Janik313/Pflanzenwagen/40_Realisieren/Konzeptskizze.jpg

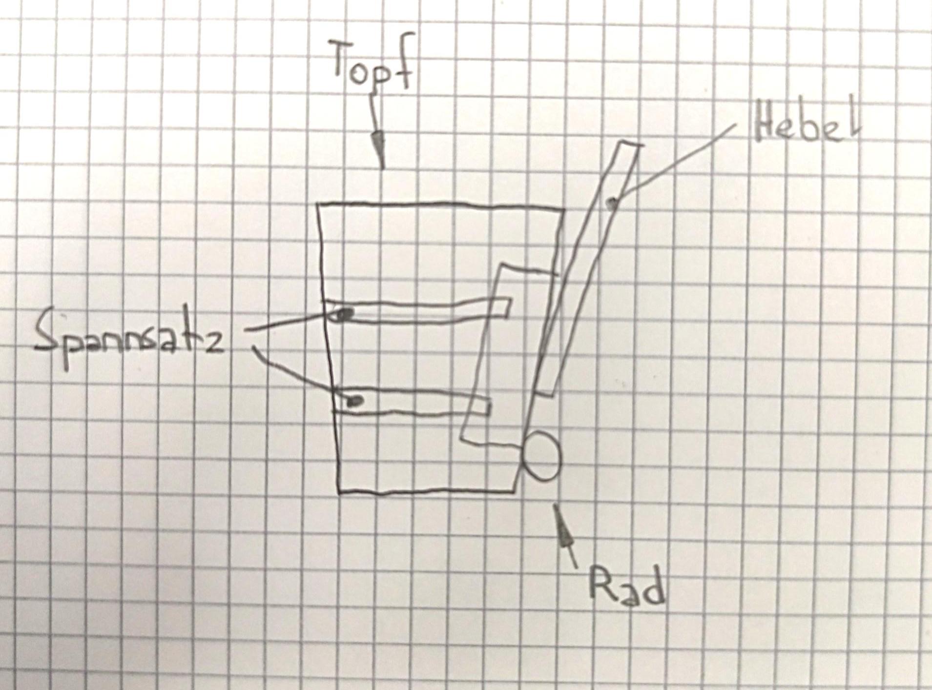
40_Realisieren/Konzeptskizze.jpg
