Janik313/Pflanzenwagen/20_Planen/Varianten/Variante3.png

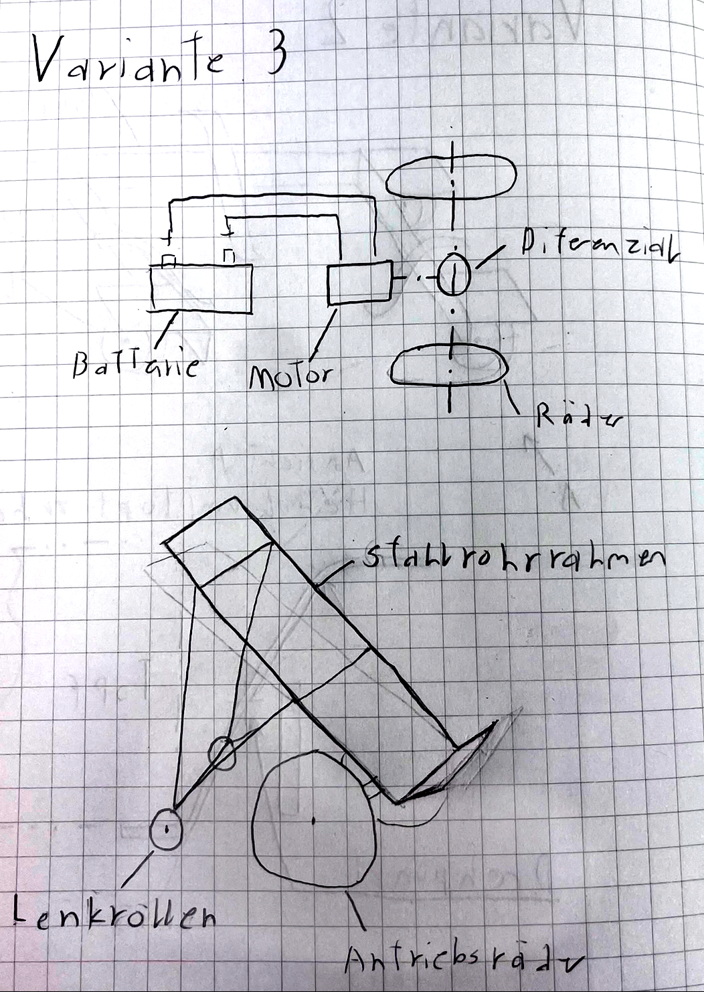
20_Planen/Varianten/Variante3.png
