Janik313/Pflanzenwagen/40_Realisieren/20_Inventor/20_Einkaufteile/Links zu teile.txt

Wheel
https://www.bauhaus.info/ersatzraeder/altrad-sackkarren-ersatzrad/p/25456800#anchor-product-services

Ratchet Strap
https://www.galaxus.ch/de/s4/product/spanset-zurrgurte-spanngurt-ladungssicherung-6051863

Roh Material Roh
https://shop.d-a.ch/de/Konstruktionsrohre-Stahl-S235JR-geschweisst-rohschwarz/p/M100610
(21/2" 76.1 3.6 6) für Hebel

https://shop.d-a.ch/de/Konstruktionsrohre-Stahl-S235JR-geschweisst-rohschwarz/p/M100610
(11/2" 48.3 3.20) für Griff

Mutter achse
BN 161 1118811 Sicherungsmutter M20

Round slider 42x2,5-5
https://www.emico.com/en-DE/emico/protective-products/pipe-inserts-lamellar-plugs/round-sliders-42x25-5-0850425
