Janik313/Pflanzenwagen/10_Informieren/Pflichtenheft.docx

Projektname:Pflanzenwagen Bearbeiter: Janik Wyder & Raoul Messerli
Anforderungen / Einflussgrössen | | F / W(G)

Bildschirmausschnitt

Funktions- und Leistungsanforderungen | - Pflanzentopf soll ohne merklichen Aufwand mit der Einrichtung aufgenommen werden können - Vorrichtung funktioniert auf unebenem Boden (Schotter) - Tragkraft bis 250kg | F F F

Bildschirmausschnitt

Qualitätsmerkmale | - Suva-Richtlinien beachten - Alle Einzelteilzeichnungen im CAD erstellt und vorhanden - Ein 3D CAD-Modell der Baugruppe muss vorhanden sein - Lange Lebensdauer | F F F W(4)

Bildschirmausschnitt

Marktanforderungen | - Einfache Bedienung durch eine Person | F

Bildschirmausschnitt

Fertigungskriterien | - Seriegrösse: 100 Stück - Einfache Herstellung möglich | F W(3)
Umweltaspekte | - Rezyklierbares Material | W(3)

Bildschirmausschnitt

Kosten | - Marktpreis zwischen 200.- und 400.- - Möglichst niedrige Kosten | F W(2)

Bildschirmausschnitt

Termine | Abgabe Projekt: 07.02.2023

Freigabe Auftraggeber:

Datum, Name: _________________________ Unterschrift: _________________________

F = Forderung (Vorgaben, die zwingend zu erfüllen sind)

W = Wunsch, (G) = Gewichtung Wunsch → 1 = schwacher Wunsch, 5 = starker Wunsch

\\intern.ch.rondodoge.com\users\Homes\Lang_a\Documents\Meine Datenquellen\1_RONDO\Projekte\Pflichtenheft Übung Taschenmesser.docx 09.01.2023 / LaA 5 / 6
