Janik313/Pflanzenwagen/40_Realisieren/20_Inventor/50_Berechung/Beruchungen.docx

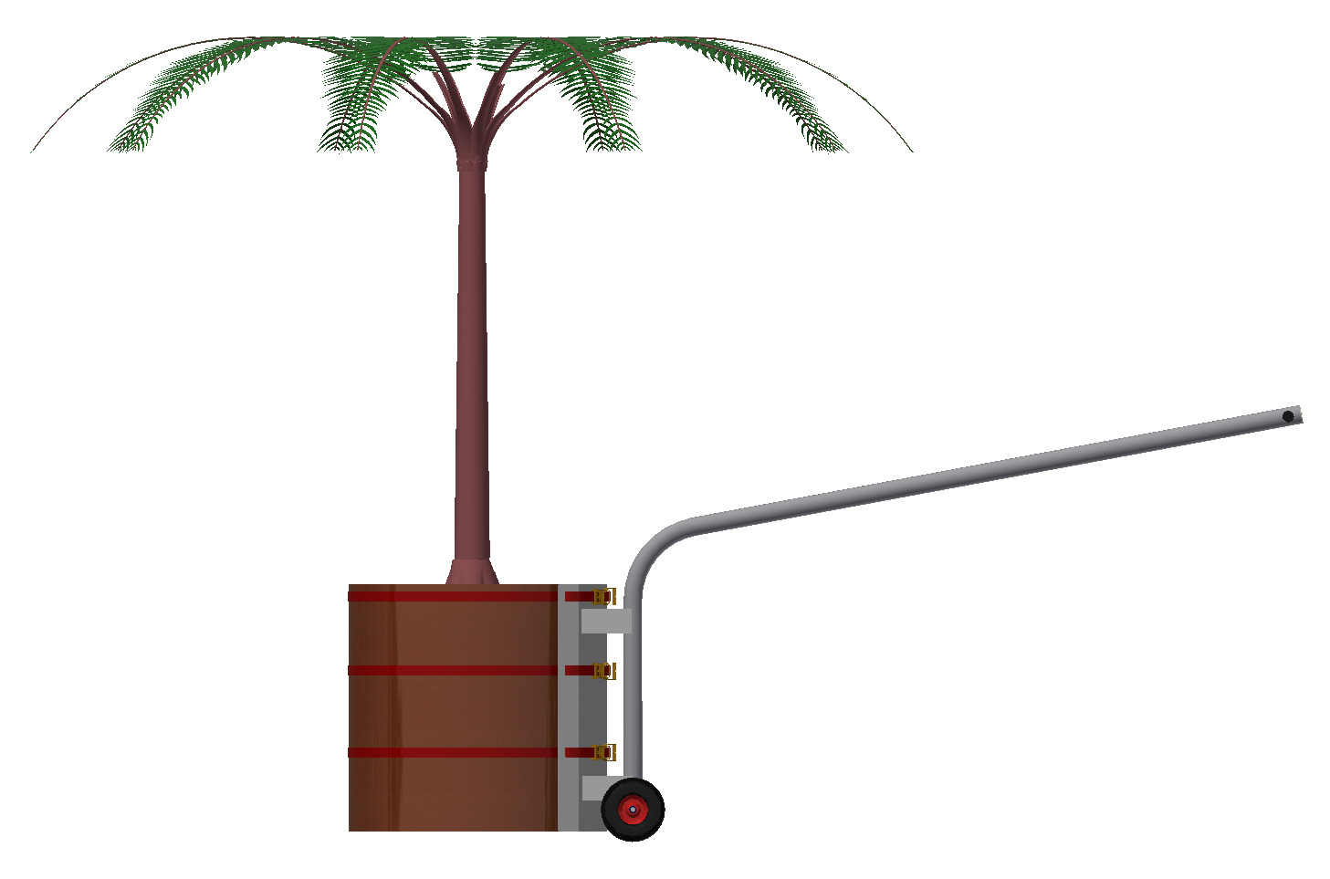
[picture p43: figure]

Hebel Länge:

Ftopf: 250 Kg

ltopf: 650mm

Fhebel: 400 N

g ≈ 10 m/s²

Gesucht lhebel

l_(hebel) =(F_(topf) ×l_(topf))/(F_(hebel))=(2500N×500mm)/(400N)=3125mm
