Janik313/Pflanzenwagen/00_Dokumentation/90_Vorlagen_Rondo/Anhang_Doku/2022 Projekte Workshop.docx

# 1 Vorrichtung für das Nachbearbeiten der geschweissten Walzen

Bevor die geschweissten Walzen auf der Mazak bearbeitet werden können, müssen Schweissspritzer und stark überstehende Schweissnähte weggeschliffen oder weggefeilt werden.

Es ist eine geeignete Vorrichtung zu entwickeln, wo die Walzen nur draufgelegt werden können und dann mithilfe eines Drehantriebes langsam rotieren. Dies würde das Nacharbeiten der Schweissnähte und Schweissspritzer sehr erleichtern.

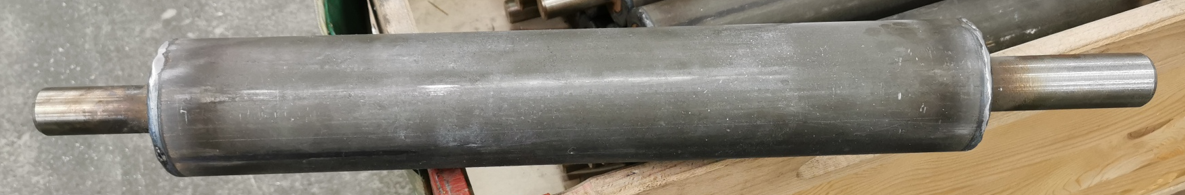
[picture p44: figure]
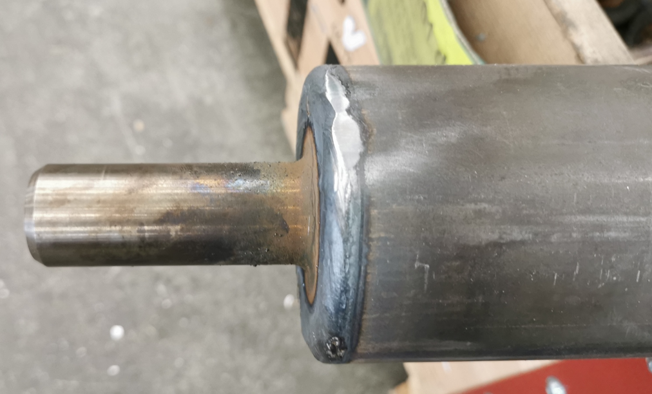
[picture p45: figure]

Entfernte Spritzer Schweissnaht geschliffen

Zu klären:

- Welche Walzen (Ø86, Ø100) ev. auch Walzen RONDO Schio (Ø150)?
- Welche Walzenlängen ev. auch Walzen RONDO Schio?
- Drehgeschwindigkeit? Soll diese regelbar sein?
- Steuerung, wo wer und wie?
- Wo soll die Vorrichtung aufgebaut sein (Wagen, Tisch, etc…)

Auftraggeber / Ansprechpartner

VF (Hansruedi Leuenberger) / WZ (Andreas Aebersold)

g:\berufsbildung\02 berufsbildungs-kommission\08_workshop\workshop 2022 - eriz\projekte\2022 projekte workshop .docx 31.03.202214 / 14

Workshop 2022 Projekte

Titel eingeben
