Janik313/Pflanzenwagen/00_Dokumentation/90_Vorlagen_Rondo/Pflichtenheft_2_unterschrieben.pdf

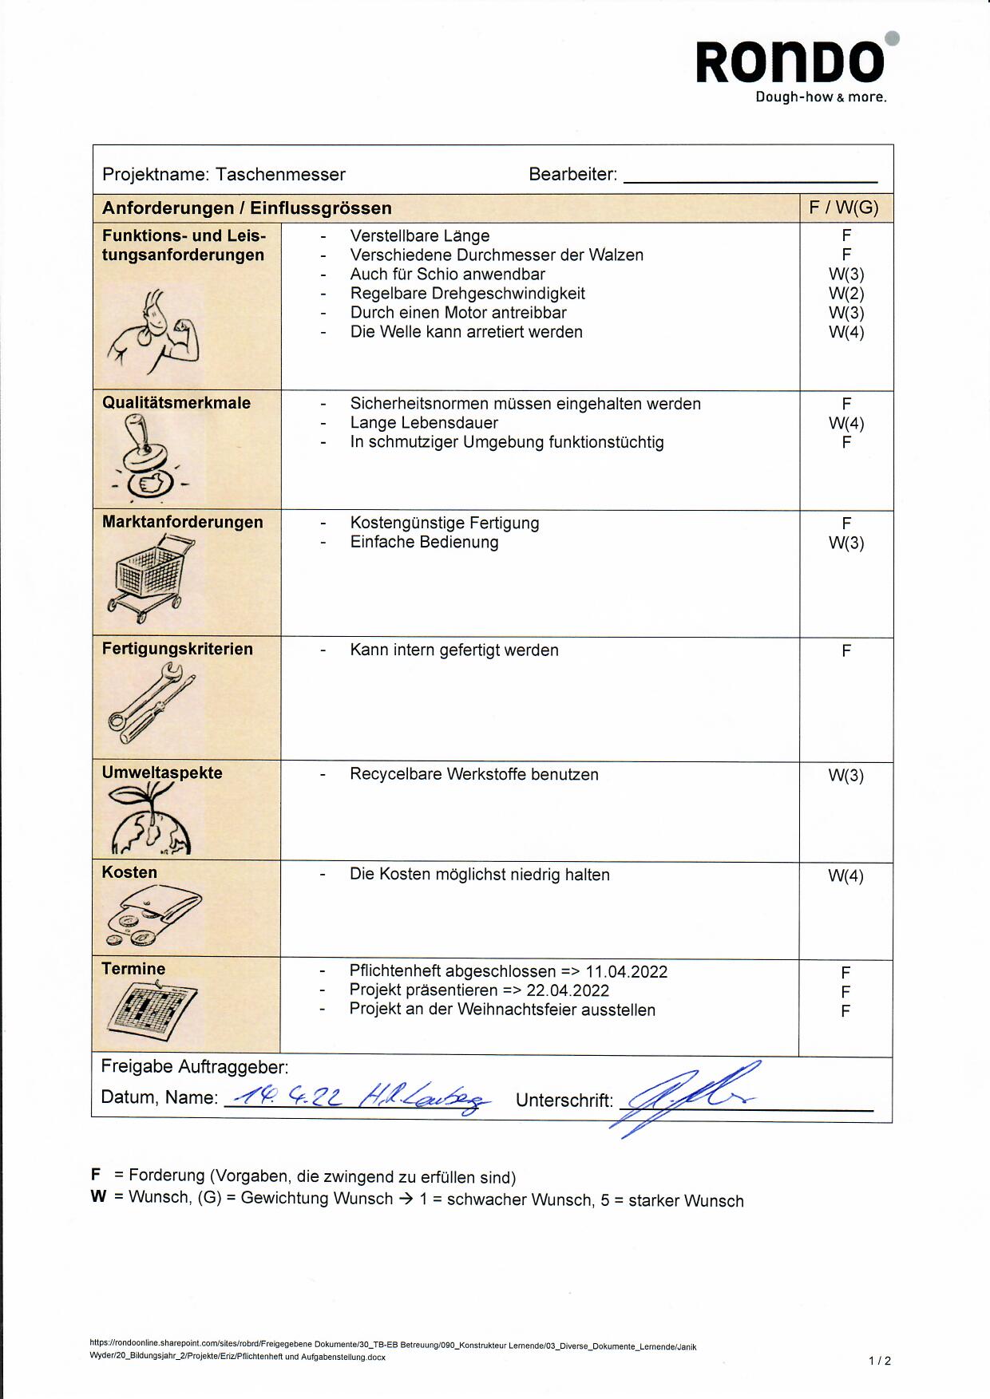
[picture p46: page 1]
