Janik313/Pflanzenwagen/20_Planen/Varianten/Variante1.png

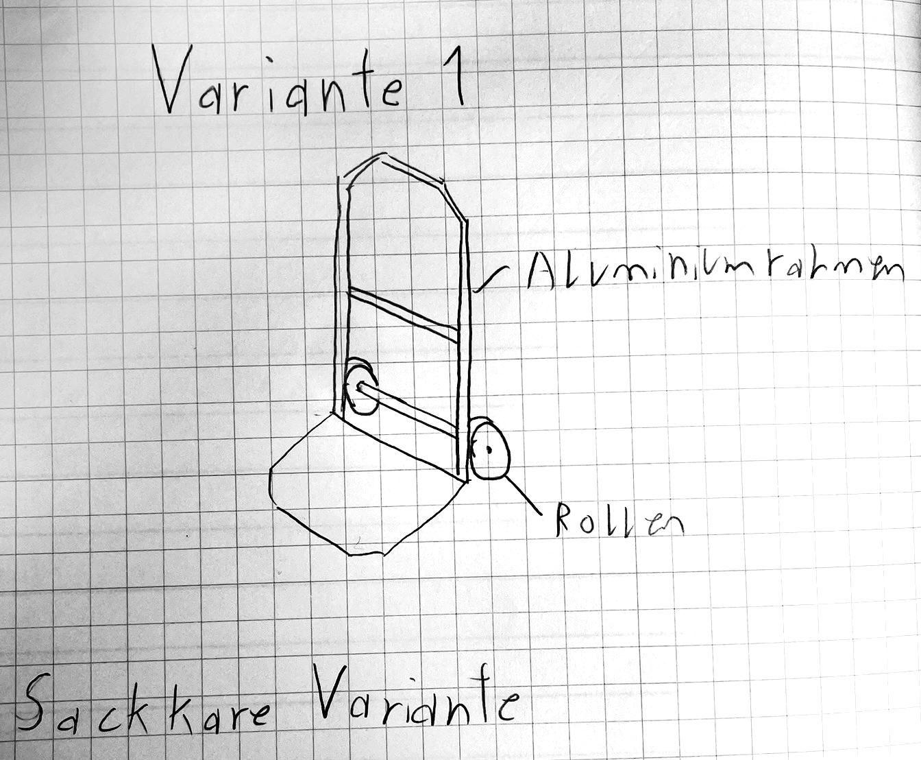
20_Planen/Varianten/Variante1.png
