Janik313/Pflanzenwagen/40_Realisieren/Berechnung_Hebellänge.jpg

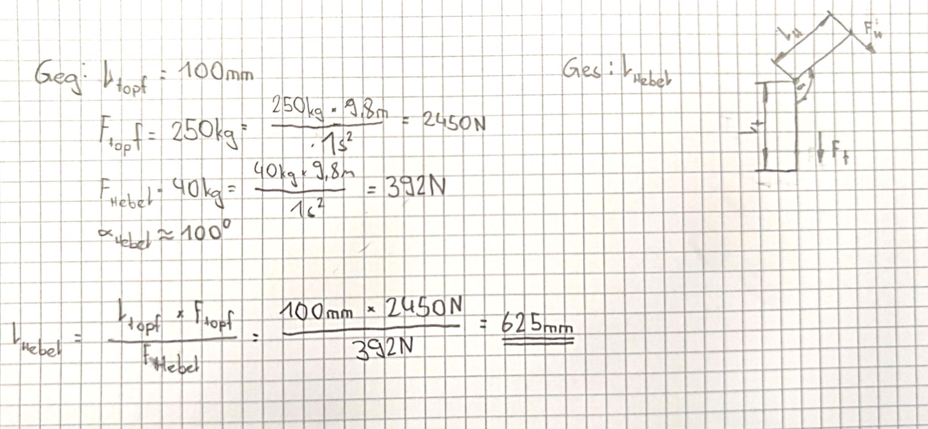
40_Realisieren/Berechnung_Hebellänge.jpg
