Janik313/Pflanzenwagen/50_Kontrollieren/Kostenkalkulation.xlsx

Kosten
Teil | Anzahl | Stückkosten | Kosten Total
Rohmaterial Blech | 1 | CHF 150.00 | CHF 100.00
Rohmaterial Rohr | 1 | CHF 60.00 | CHF 60.00
Herstellungskosten | 1 | CHF 200.00 | CHF 100.00
Spanngurte | 3 | CHF 31.50 | CHF 94.50
Räder | 2 | CHF 19.95 | CHF 39.90
Stopfen | 2 | CHF 0.43 | CHF 0.86
Total |  |  | CHF 395.26
 |  |  |  | Seriegrösse 100.-
 |  |  |  | Preis zwischen 200.- und 400.-
