Janik313/Pflanzenwagen/00_Dokumentation/90_Vorlagen_Rondo/Kostenplanung.xlsx

Sheet: Kostenplanung (Schätzung)
Kosten
Rohmaterial | CHF 150.00
Entwicklungskosten | CHF 400.00
Motor | CHF 300.00
Sonstige Einkaufteile | CHF 50.00
Herstellungskosten | CHF 100.00
Total: | CHF 1000.00

Sheet: Kosten
Kosten
Rohmaterial | CHF 75.00
Entwicklungskosten | CHF 150.00
Igus Bauteile | CHF 84.00
Rastbolzen | CHF 23.90
Herstellungskosten | CHF 50.00
Total: | CHF 382.90

Sheet: Rechner
Rohmaterial
Gewicht (kg)
Kosten pro kg
Total: | 0
Entwicklungskosten
Stundenlohn
Benötigte Zeit
Total: | 0
Einkaufsteile | Anzahl | Preis | Total
 |  |  | 0
 |  |  |  | Monatslohn | 890
 |  |  |  | Stundenlohn | 5.5625 | 9.625
 |  |  | Entwicklungskosten (Zeit), Herstellkosten, Einkaufteile, Montagekosten, etc.
