Janik313/Pflanzenwagen/40_Realisieren/20_Inventor/20_Einkaufteile/RatchetStrap/RatchetStrap.stp

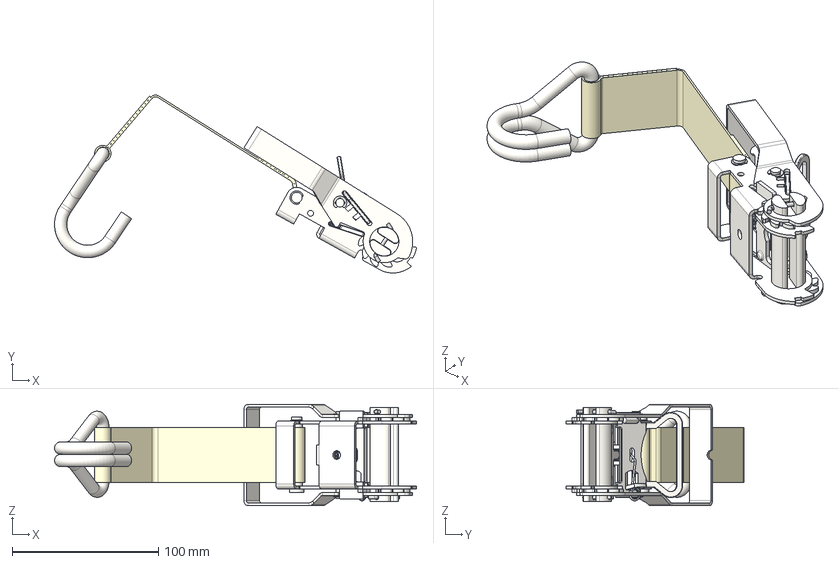
[picture p49: CAD file, 2023-02-01]
40_Realisieren/20_Inventor/20_Einkaufteile/RatchetStrap/RatchetStrap.stp
247.8 x 121.8 x 69.5 mm
rct
Hook
Part4^RatchetStrap
Latch1
Cross x 2
Pin x 2
Pin2
C_clip x 3
Strap
MiddleBracket
DynamicSpring
Pin1
Gear x 2
Latch2
