Janik313/Pflanzenwagen/(list of files, cad)

Other CAD files:
40_Realisieren/20_Inventor/Templates/OldVersions/Standard.0002.dwg
40_Realisieren/20_Inventor/Templates/OldVersions/Norm.0001.dwg
40_Realisieren/20_Inventor/10_Vorlage/OldVersions/Palme.0004.iam
40_Realisieren/20_Inventor/10_Vorlage/OldVersions/Topf.0005.ipt
40_Realisieren/20_Inventor/10_Vorlage/Palme.iam
40_Realisieren/20_Inventor/10_Vorlage/Topf.ipt
40_Realisieren/20_Inventor/20_Einkaufteile/BN 161 1118811 prevailing torque type hex lock nut M20_Steel 6.ipt
40_Realisieren/20_Inventor/20_Einkaufteile/Gummi Matte DRW.ipt
40_Realisieren/20_Inventor/20_Einkaufteile/Gummi Matte.ipt
40_Realisieren/20_Inventor/20_Einkaufteile/OldVersions/BN 161 1118811 prevailing torque type hex lock nut M20_Steel 6.0001.ipt
40_Realisieren/20_Inventor/20_Einkaufteile/OldVersions/Gummi Matte.0002.ipt
40_Realisieren/20_Inventor/20_Einkaufteile/RatchetStrap/C_clip.ipt
40_Realisieren/20_Inventor/20_Einkaufteile/RatchetStrap/Cross.ipt
40_Realisieren/20_Inventor/20_Einkaufteile/RatchetStrap/DynamicSpring.ipt
40_Realisieren/20_Inventor/20_Einkaufteile/RatchetStrap/Gear.ipt
40_Realisieren/20_Inventor/20_Einkaufteile/RatchetStrap/Hook.ipt
40_Realisieren/20_Inventor/20_Einkaufteile/RatchetStrap/Latch1.ipt
40_Realisieren/20_Inventor/20_Einkaufteile/RatchetStrap/Latch2.ipt
40_Realisieren/20_Inventor/20_Einkaufteile/RatchetStrap/MiddleBracket.ipt
40_Realisieren/20_Inventor/20_Einkaufteile/RatchetStrap/OldVersions/C_clip.0001.ipt
40_Realisieren/20_Inventor/20_Einkaufteile/RatchetStrap/OldVersions/Cross.0001.ipt
40_Realisieren/20_Inventor/20_Einkaufteile/RatchetStrap/OldVersions/DynamicSpring.0001.ipt
40_Realisieren/20_Inventor/20_Einkaufteile/RatchetStrap/OldVersions/Gear.0001.ipt
40_Realisieren/20_Inventor/20_Einkaufteile/RatchetStrap/OldVersions/Latch1.0001.ipt
40_Realisieren/20_Inventor/20_Einkaufteile/RatchetStrap/OldVersions/Latch2.0001.ipt
40_Realisieren/20_Inventor/20_Einkaufteile/RatchetStrap/OldVersions/MiddleBracket.0001.ipt
40_Realisieren/20_Inventor/20_Einkaufteile/RatchetStrap/OldVersions/Part4^RatchetStrap.0001.ipt
40_Realisieren/20_Inventor/20_Einkaufteile/RatchetStrap/OldVersions/Pin.0001.ipt
40_Realisieren/20_Inventor/20_Einkaufteile/RatchetStrap/OldVersions/Pin1.0001.ipt
40_Realisieren/20_Inventor/20_Einkaufteile/RatchetStrap/OldVersions/Pin2.0001.ipt
40_Realisieren/20_Inventor/20_Einkaufteile/RatchetStrap/OldVersions/Strap for Pflanzenwagen.0004.ipt
40_Realisieren/20_Inventor/20_Einkaufteile/RatchetStrap/OldVersions/rct.0001.ipt
40_Realisieren/20_Inventor/20_Einkaufteile/RatchetStrap/Part4^RatchetStrap.ipt
40_Realisieren/20_Inventor/20_Einkaufteile/RatchetStrap/Pin.ipt
40_Realisieren/20_Inventor/20_Einkaufteile/RatchetStrap/Pin1.ipt
40_Realisieren/20_Inventor/20_Einkaufteile/RatchetStrap/Pin2.ipt
40_Realisieren/20_Inventor/20_Einkaufteile/RatchetStrap/RatchetStrap/OldVersions/RatchetStrap.0004.iam
40_Realisieren/20_Inventor/20_Einkaufteile/RatchetStrap/RatchetStrap/RatchetStrap.iam
40_Realisieren/20_Inventor/20_Einkaufteile/RatchetStrap/Strap for Pflanzenwagen.ipt
40_Realisieren/20_Inventor/20_Einkaufteile/RatchetStrap/Strap.ipt
40_Realisieren/20_Inventor/20_Einkaufteile/RatchetStrap/rct.ipt
40_Realisieren/20_Inventor/20_Einkaufteile/Round_sliders.ipt
40_Realisieren/20_Inventor/20_Einkaufteile/Wheel.ipt
40_Realisieren/20_Inventor/30_Fertigungsteile/Achse.idw
40_Realisieren/20_Inventor/30_Fertigungsteile/Achse.ipt
40_Realisieren/20_Inventor/30_Fertigungsteile/Blech1.idw
40_Realisieren/20_Inventor/30_Fertigungsteile/Blech1.ipt
40_Realisieren/20_Inventor/30_Fertigungsteile/Deckel.idw
40_Realisieren/20_Inventor/30_Fertigungsteile/Deckel.ipt
40_Realisieren/20_Inventor/30_Fertigungsteile/Griff.idw
40_Realisieren/20_Inventor/30_Fertigungsteile/Griff.ipt
40_Realisieren/20_Inventor/30_Fertigungsteile/Gummi Matte.idw
40_Realisieren/20_Inventor/30_Fertigungsteile/Halteblech.idw
40_Realisieren/20_Inventor/30_Fertigungsteile/Halteblech.ipt
40_Realisieren/20_Inventor/30_Fertigungsteile/Hebel.idw
40_Realisieren/20_Inventor/30_Fertigungsteile/Hebel.ipt
40_Realisieren/20_Inventor/30_Fertigungsteile/Keil.idw
40_Realisieren/20_Inventor/30_Fertigungsteile/Keil.ipt
40_Realisieren/20_Inventor/30_Fertigungsteile/OldVersions/Achse.0002.ipt
40_Realisieren/20_Inventor/30_Fertigungsteile/OldVersions/Achse.0007.idw
40_Realisieren/20_Inventor/30_Fertigungsteile/OldVersions/Blech1.0005.ipt
40_Realisieren/20_Inventor/30_Fertigungsteile/OldVersions/Blech1.0014.idw
40_Realisieren/20_Inventor/30_Fertigungsteile/OldVersions/Deckel.0002.idw
40_Realisieren/20_Inventor/30_Fertigungsteile/OldVersions/Deckel.0003.ipt
40_Realisieren/20_Inventor/30_Fertigungsteile/OldVersions/Griff.0001.ipt
40_Realisieren/20_Inventor/30_Fertigungsteile/OldVersions/Griff.0005.idw
40_Realisieren/20_Inventor/30_Fertigungsteile/OldVersions/Gummi Matte.0001.idw
40_Realisieren/20_Inventor/30_Fertigungsteile/OldVersions/Halteblech.0003.idw
40_Realisieren/20_Inventor/30_Fertigungsteile/OldVersions/Halteblech.0004.ipt
40_Realisieren/20_Inventor/30_Fertigungsteile/OldVersions/Hebel.0005.idw
40_Realisieren/20_Inventor/30_Fertigungsteile/OldVersions/Hebel.0007.ipt
40_Realisieren/20_Inventor/30_Fertigungsteile/OldVersions/Keil.0003.ipt
40_Realisieren/20_Inventor/30_Fertigungsteile/OldVersions/Keil.0006.idw
40_Realisieren/20_Inventor/30_Fertigungsteile/OldVersions/Rad Aufnahme.0004.ipt
40_Realisieren/20_Inventor/30_Fertigungsteile/OldVersions/Rad Aufnahme.0009.idw
40_Realisieren/20_Inventor/30_Fertigungsteile/Rad Aufnahme.idw
40_Realisieren/20_Inventor/30_Fertigungsteile/Rad Aufnahme.ipt
40_Realisieren/20_Inventor/40_Baugruppen/Baugruppe.iam
40_Realisieren/20_Inventor/40_Baugruppen/Baugruppe.idw
40_Realisieren/20_Inventor/40_Baugruppen/Baugruppe.newVer.iam
40_Realisieren/20_Inventor/40_Baugruppen/OldVersions/Baugruppe.0005.idw
40_Realisieren/20_Inventor/40_Baugruppen/OldVersions/Baugruppe.0006.iam
40_Realisieren/20_Inventor/40_Baugruppen/OldVersions/Sandbox.0011.iam
40_Realisieren/20_Inventor/40_Baugruppen/OldVersions/Schweiss Baugruppe.0002.idw
40_Realisieren/20_Inventor/40_Baugruppen/OldVersions/Schweiss Baugruppe.0008.iam
40_Realisieren/20_Inventor/40_Baugruppen/Sandbox.iam
40_Realisieren/20_Inventor/40_Baugruppen/Schweiss Baugruppe.iam
40_Realisieren/20_Inventor/40_Baugruppen/Schweiss Baugruppe.idw
40_Realisieren/20_Inventor/Templates/OldVersions/Blech.0002.ipt
40_Realisieren/20_Inventor/Templates/OldVersions/Norm.0001.ipn
40_Realisieren/20_Inventor/Templates/OldVersions/Norm.0002.iam
40_Realisieren/20_Inventor/Templates/OldVersions/Norm.0003.ipt
40_Realisieren/20_Inventor/Templates/OldVersions/Norm.0009.idw
40_Realisieren/20_Inventor/Templates/OldVersions/Schweisskonstruktion.0002.iam
40_Realisieren/20_Inventor/Templates/OldVersions/Sheet Metal.0003.ipt
40_Realisieren/20_Inventor/Templates/OldVersions/Standard.0002.ipn
40_Realisieren/20_Inventor/Templates/OldVersions/Standard.0003.iam
40_Realisieren/20_Inventor/Templates/OldVersions/Standard.0004.ipt
40_Realisieren/20_Inventor/Templates/OldVersions/Standard.0010.idw
40_Realisieren/20_Inventor/Templates/OldVersions/Weldment.0003.iam
40_Realisieren/20_Inventor/Templates/Sheet Metal.ipt
40_Realisieren/20_Inventor/Templates/Standard.iam
40_Realisieren/20_Inventor/Templates/Standard.idw
40_Realisieren/20_Inventor/Templates/Standard.ipn
40_Realisieren/20_Inventor/Templates/Standard.ipt
40_Realisieren/20_Inventor/Templates/Weldment.iam
