Janik313/Pflanzenwagen/40_Realisieren/10_Zeichungen/1000_Baugruppe.pdf

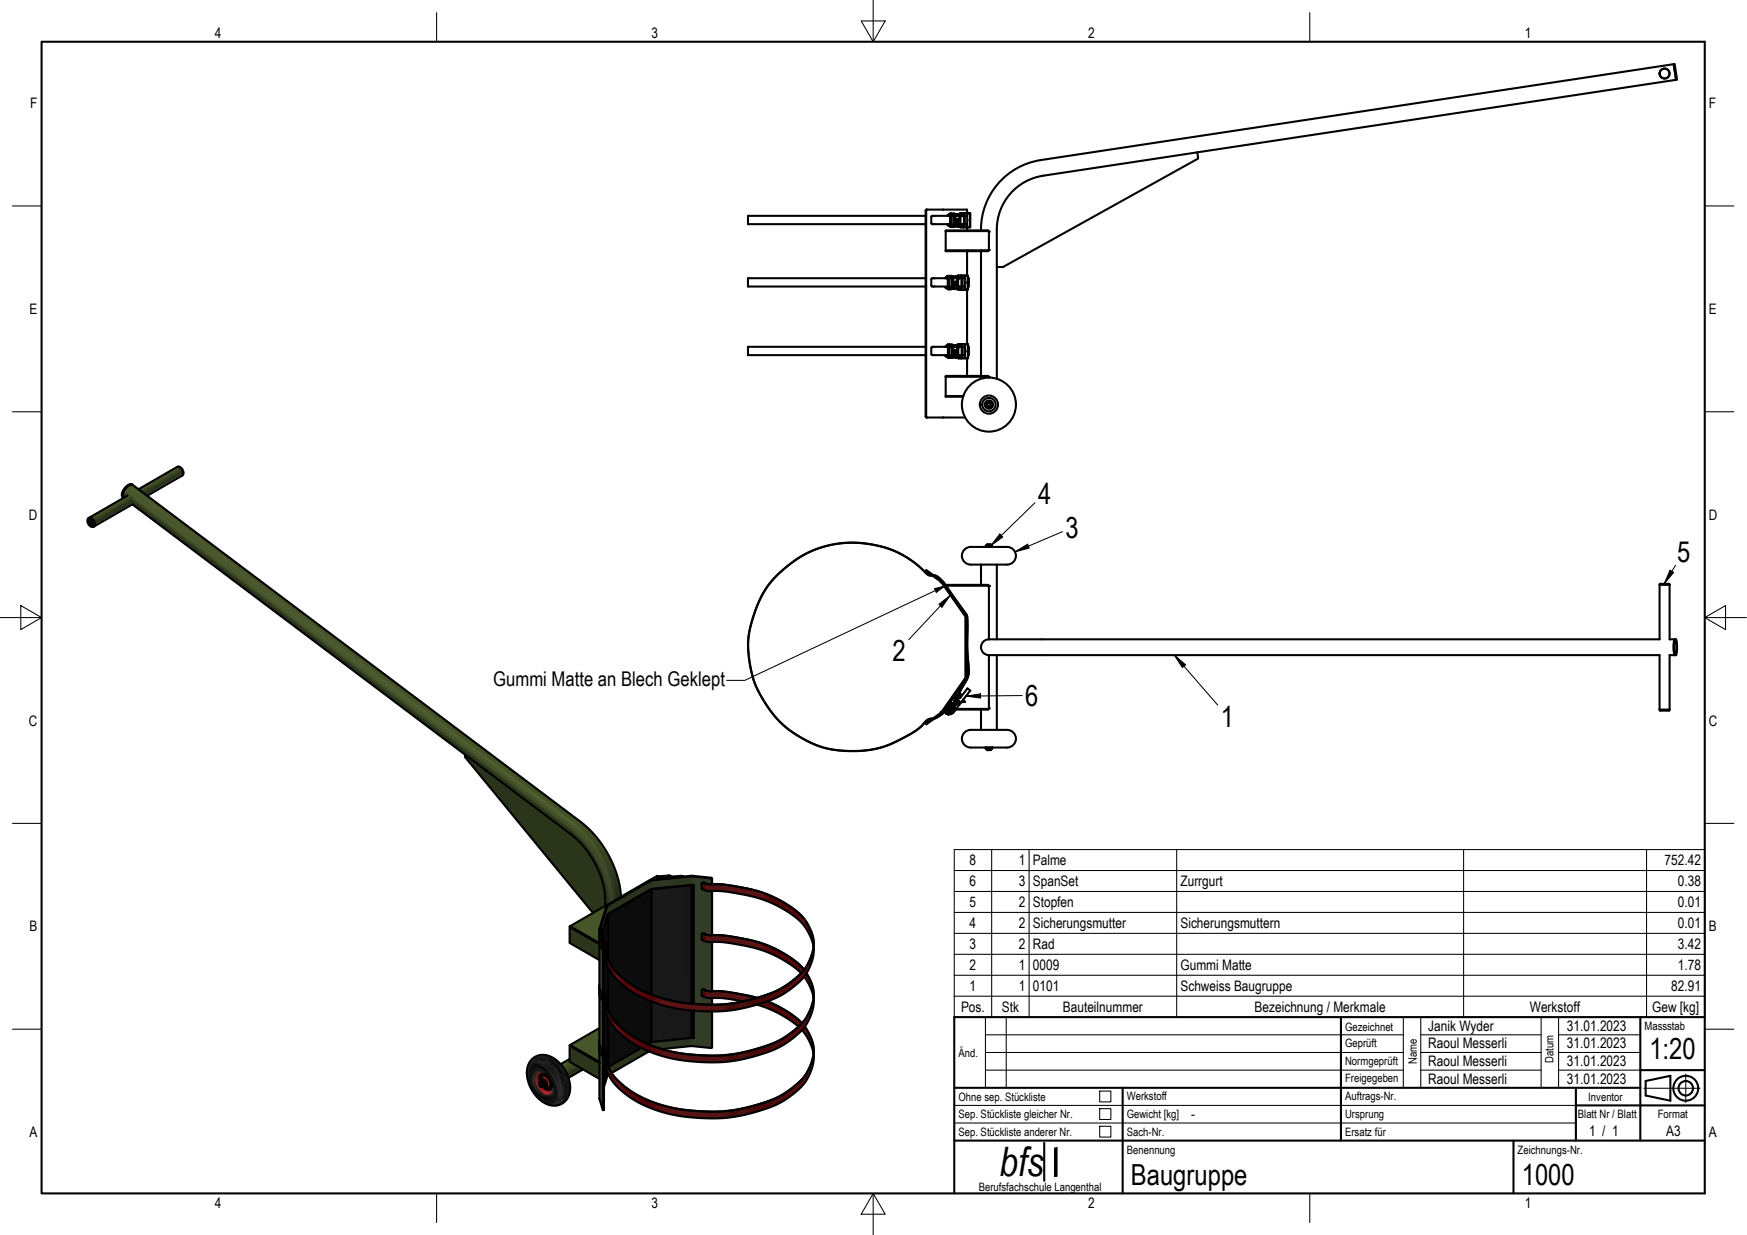
[picture p50: page 1]
Berufsfachschule Langenthal

Gummi Matte an Blech Geklept

8 | 1 | Palme | | | 752.42
6 | 3 | SpanSet | Zurrgurt | | 0.38
5 | 2 | Stopfen | | | 0.01
4 | 2 | Sicherungsmutter | Sicherungsmuttern | | 0.01
3 | 2 | Rad | | | 3.42
2 | 1 | 0009 | Gummi Matte | | 1.78
1 | 1 | 0101 | Schweiss Baugruppe | | 82.91
Pos. | Stk | Bauteilnummer | Bezeichnung / Merkmale | Werkstoff | Gew [kg]
Änd. | | | Gezeichnet | | Janik Wyder | | 31.01.2023 | Massstab 1:20

Geprüft | | Raoul Messerli | | 31.01.2023
Normgeprüft | | Raoul Messerli | | 31.01.2023
Freigegeben | | Raoul Messerli | | 31.01.2023

Ohne sep. Stückliste | | | Werkstoff | Auftrags-Nr. | Inventor
Sep. Stückliste gleicher Nr. | | | Gewicht [kg] - | Ursprung | Blatt Nr / Blatt 1 / 1 | Format A3
Sep. Stückliste anderer Nr. | | | Sach-Nr. | Ersatz für
