Janik313/Pflanzenwagen/40_Realisieren/10_Zeichungen/0001_Blech.pdf

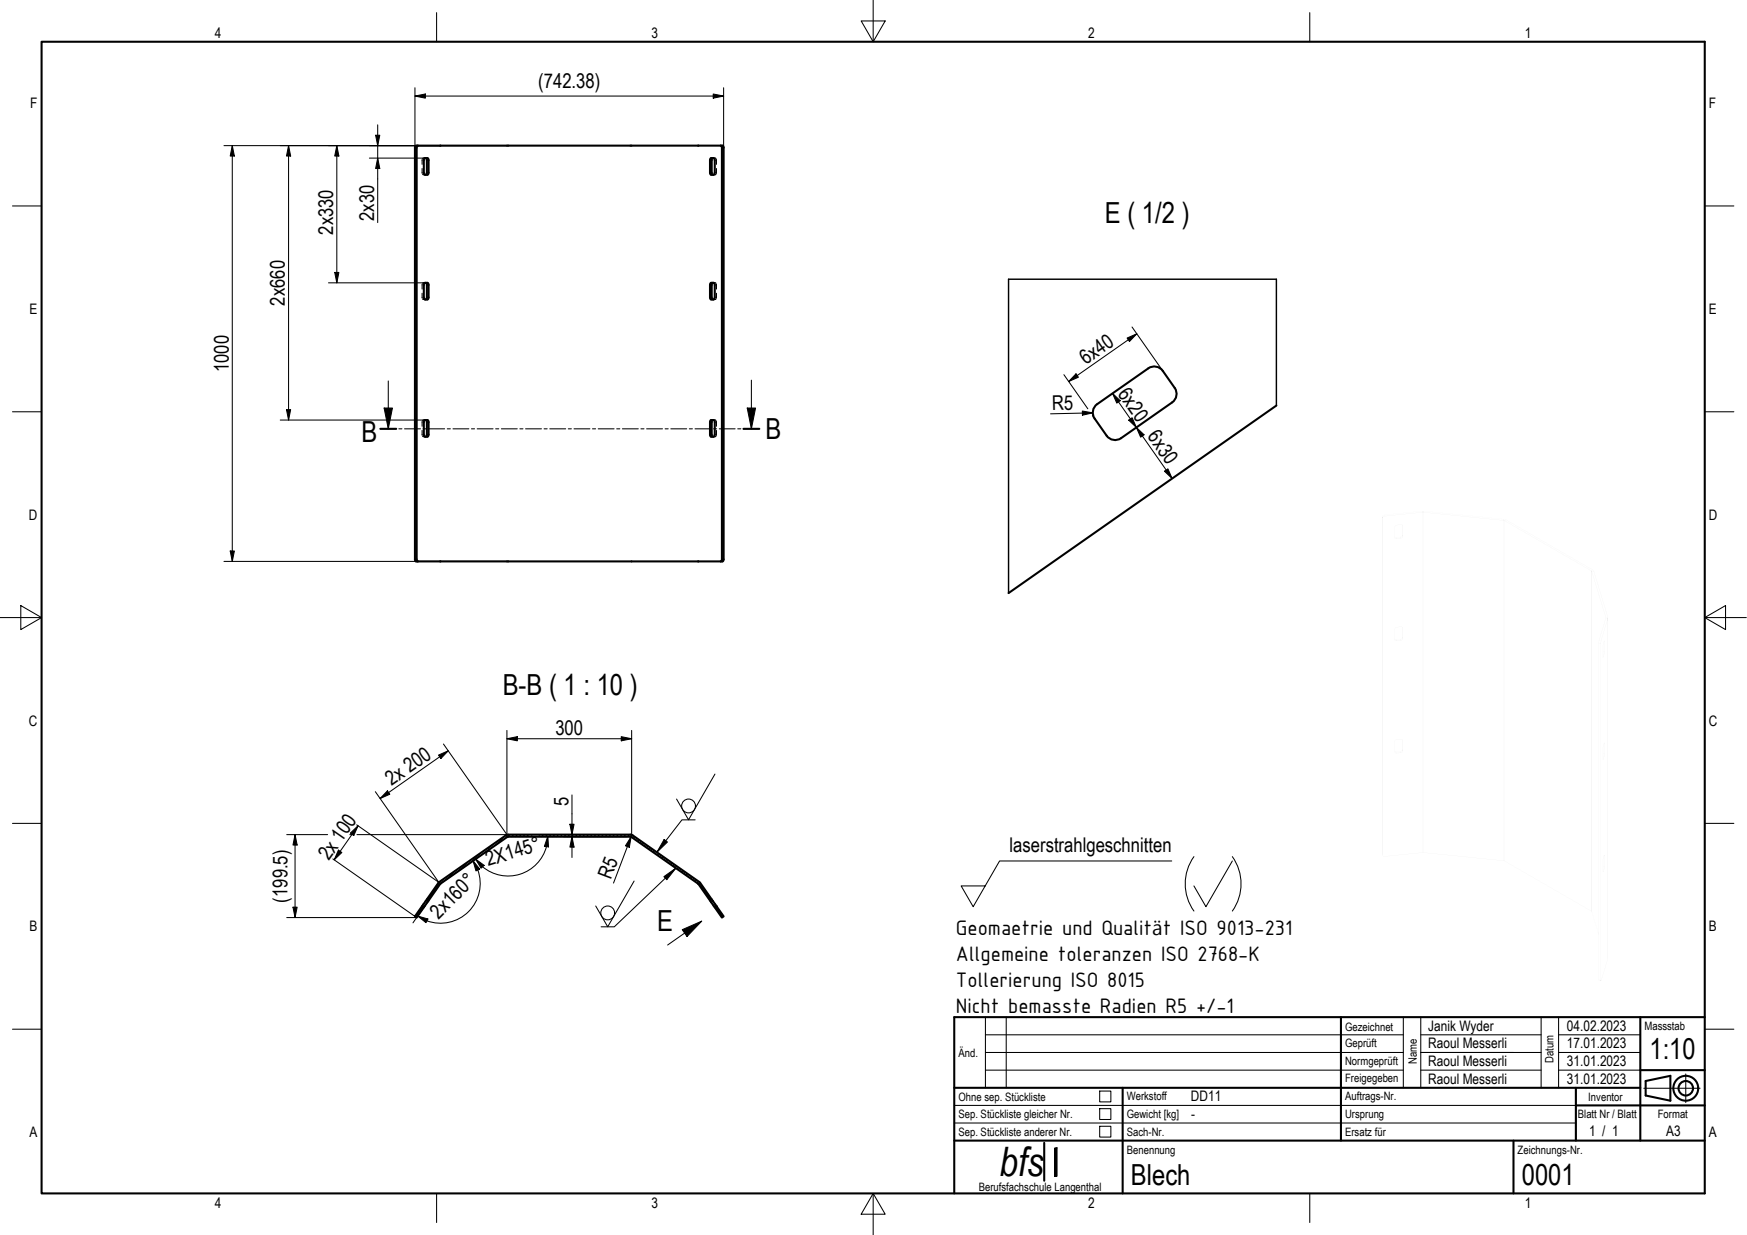
[picture p51: page 1]

r. Normgeprüft Gezeichnet Geprüft | rli Raoul Messerli Raoul Messerli Janik Wyder | 1 7.0 1.2 0 2 3

r. Sep. Stückliste gleicher Nr. Änd. Ohne sep. Stückliste

r eig e g e b e n | | R a o ul M e s s e | | 3 1.0 1.2 0 2 3

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
