Janik313/Pflanzenwagen/40_Realisieren/10_Zeichungen/0002_Achse.pdf

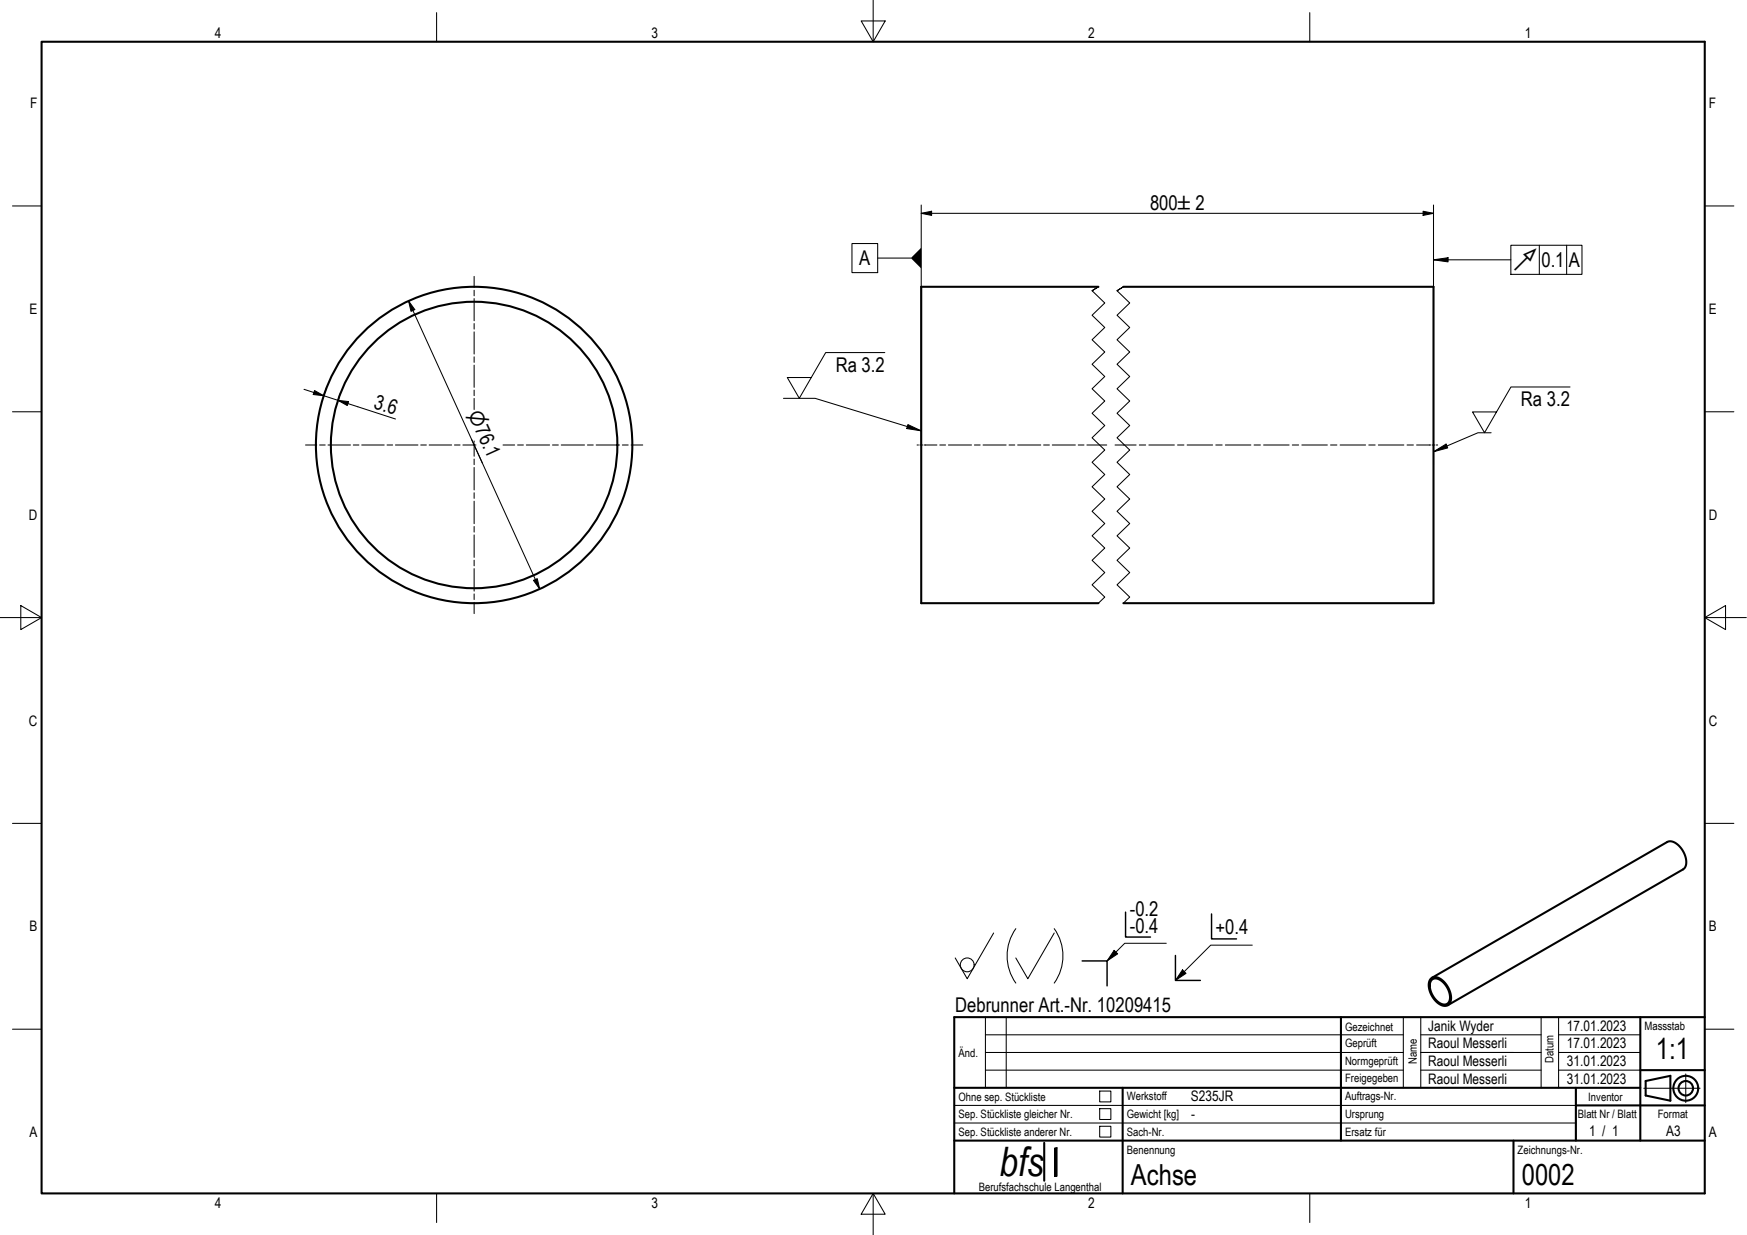
[picture p52: page 1]
Berufsfachschule Langenthal

Debrunner Art.-Nr. 10209415

Änd. | | Gezeichnet | | Janik Wyder | | 17.01.2023 | Massstab 1:1

Geprüft | | Raoul Messerli | | 17.01.2023
Normgeprüft | | Raoul Messerli | | 31.01.2023
Freigegeben | | Raoul Messerli | | 31.01.2023

Ohne sep. Stückliste | | Werkstoff S235JR | Auftrags-Nr. | Inventor
Sep. Stückliste gleicher Nr. | | Gewicht [kg] - | Ursprung | Blatt Nr / Blatt 1 / 1 | Format A3
Sep. Stückliste anderer Nr. | | Sach-Nr. | Ersatz für
