Janik313/Pflanzenwagen/40_Realisieren/10_Zeichungen/0003_Rad Aufnahme.pdf

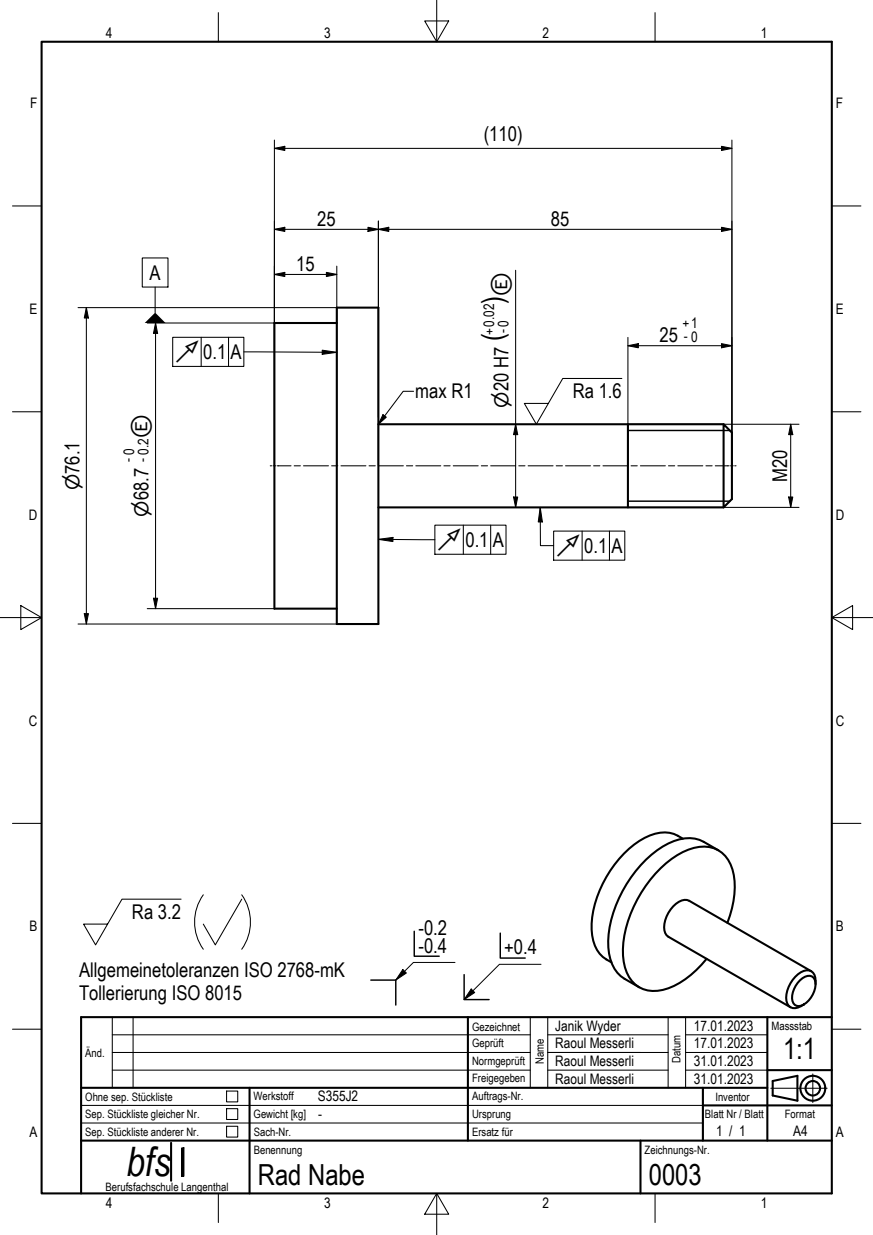
[picture p53: page 1]
Rad Nabe; Berufsfachschule Langenthal; max R1

Allgemeinetoleranzen ISO 2768-mK
Tollerierung ISO 8015

Änd. | | Gezeichnet | | Janik Wyder | | 17.01.2023 | Massstab 1:1

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

Ohne sep. Stückliste | | Werkstoff S355J2 | Auftrags-Nr. | Inventor
Sep. Stückliste gleicher Nr. | | Gewicht [kg] - | Ursprung | Blatt Nr / Blatt 1 / 1 | Format A4
Sep. Stückliste anderer Nr. | | Sach-Nr. | Ersatz für
