Janik313/Pflanzenwagen/40_Realisieren/10_Zeichungen/0004_Keil.pdf

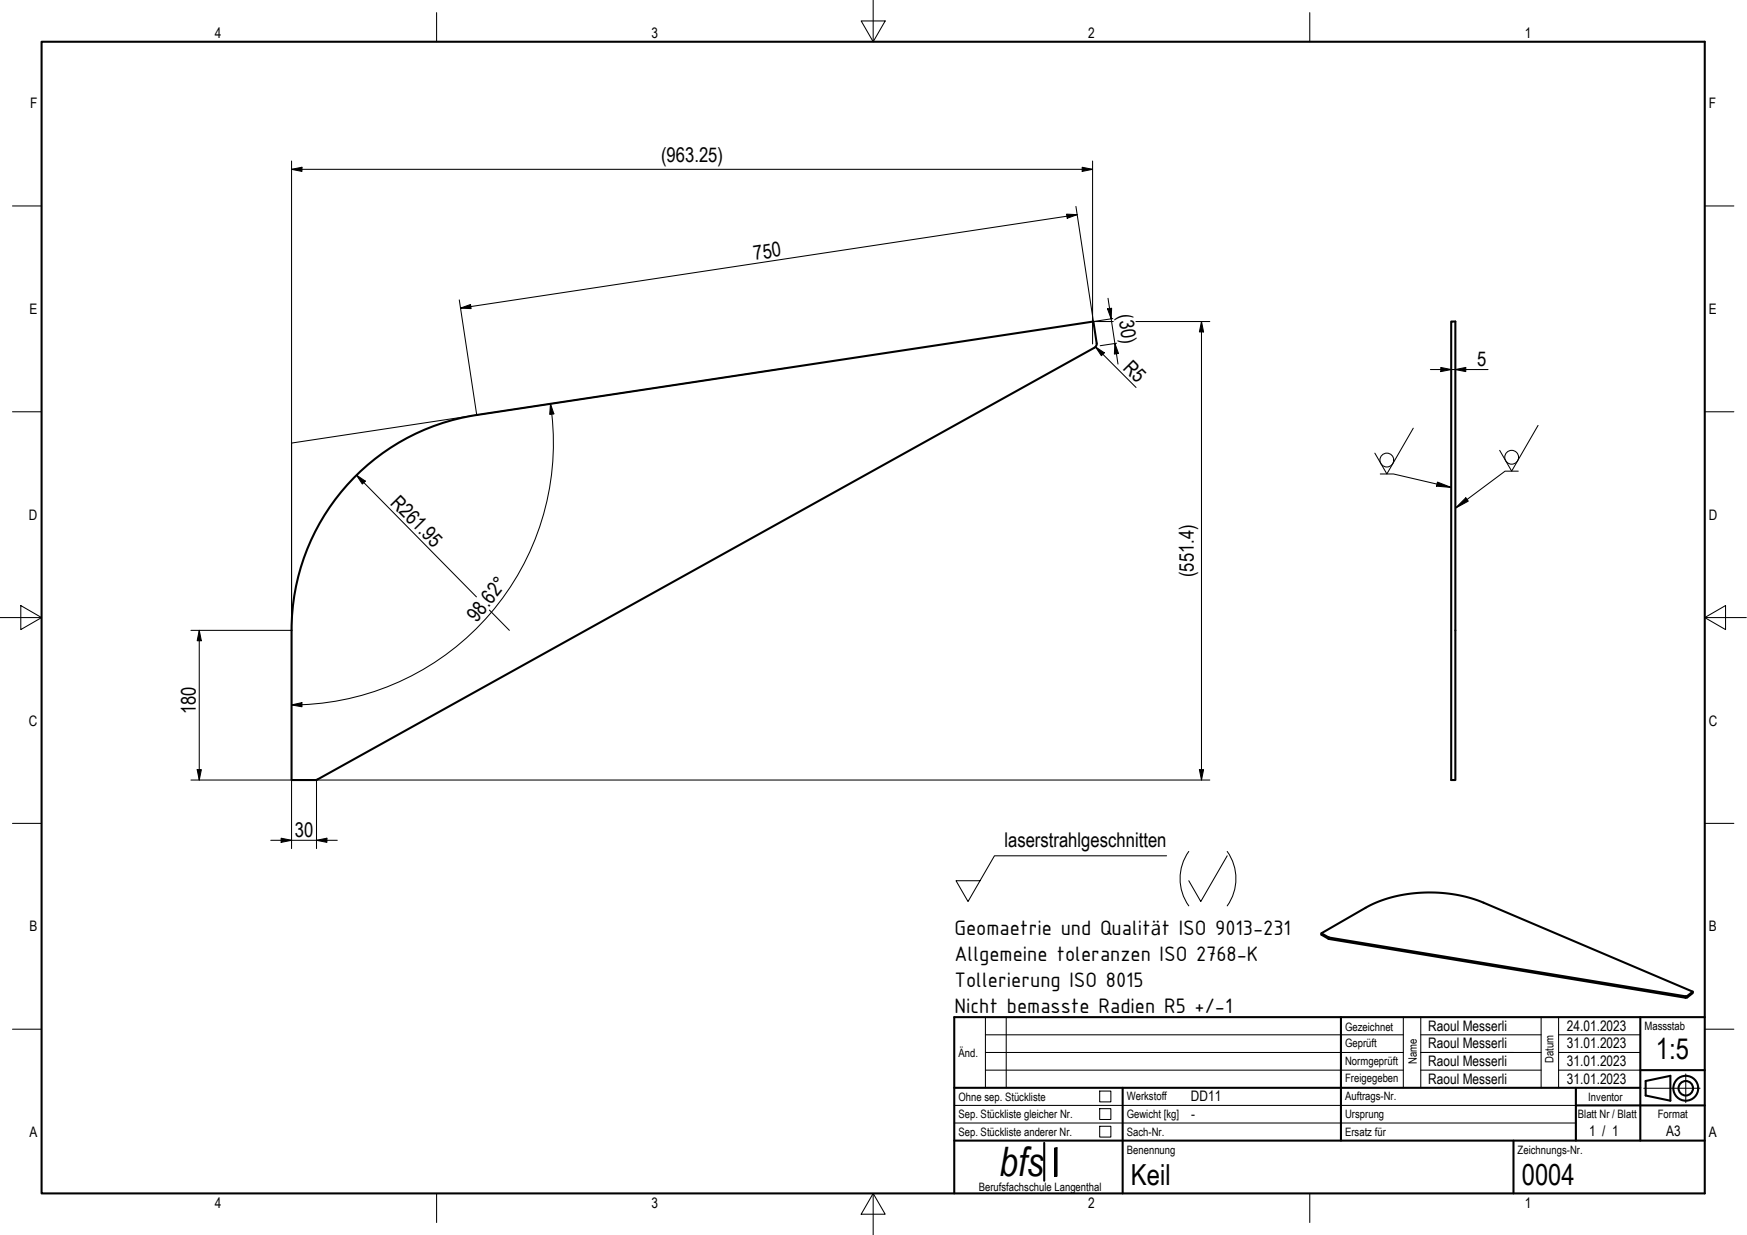
[picture p54: page 1]
Berufsfachschule Langenthal

Geomaetrie und Qualität ISO 9013-231
Allgemeine toleranzen ISO 2768-K
Tollerierung ISO 8015
Nicht bemasste Radien R5 +/-1

Änd. | | Gezeichnet | | Raoul Messerli | | 24.01.2023 | Massstab 1:5

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

Ohne sep. Stückliste | | Werkstoff DD11 | Auftrags-Nr. | Inventor
Sep. Stückliste gleicher Nr. | | Gewicht [kg] - | Ursprung | Blatt Nr / Blatt 1 / 1 | Format A3
Sep. Stückliste anderer Nr. | | Sach-Nr. | Ersatz für
