Janik313/Pflanzenwagen/40_Realisieren/10_Zeichungen/0005_Halteblech.pdf

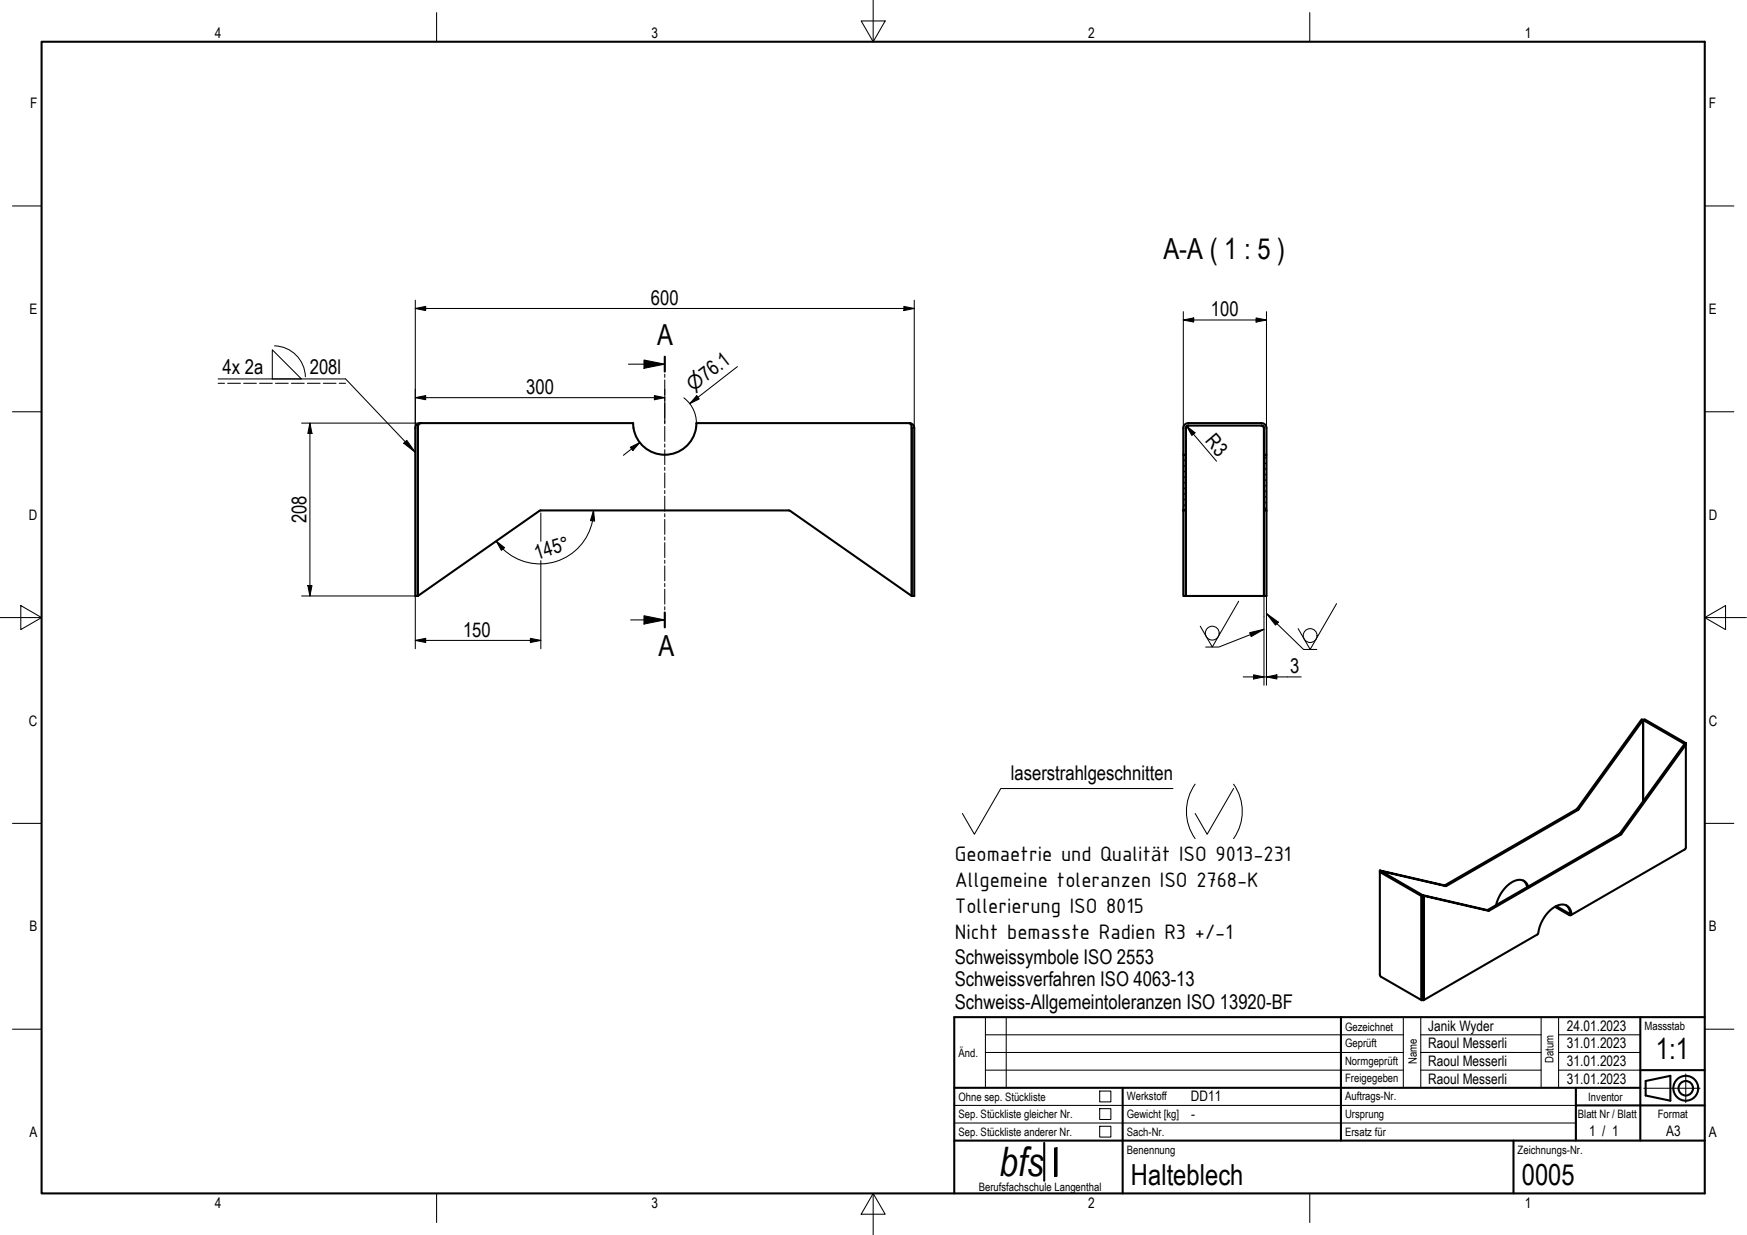
[picture p55: page 1]
Berufsfachschule Langenthal

Geomaetrie und Qualität ISO 9013-231
Allgemeine toleranzen ISO 2768-K
Tollerierung ISO 8015
Nicht bemasste Radien R3 +/-1
Schweissymbole ISO 2553
Schweissverfahren ISO 4063-13
Schweiss-Allgemeintoleranzen ISO 13920-BF

Änd. | | Gezeichnet | | Janik Wyder | | 24.01.2023 | Massstab 1:1

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
