Janik313/Pflanzenwagen/40_Realisieren/10_Zeichungen/0008_Griff.pdf

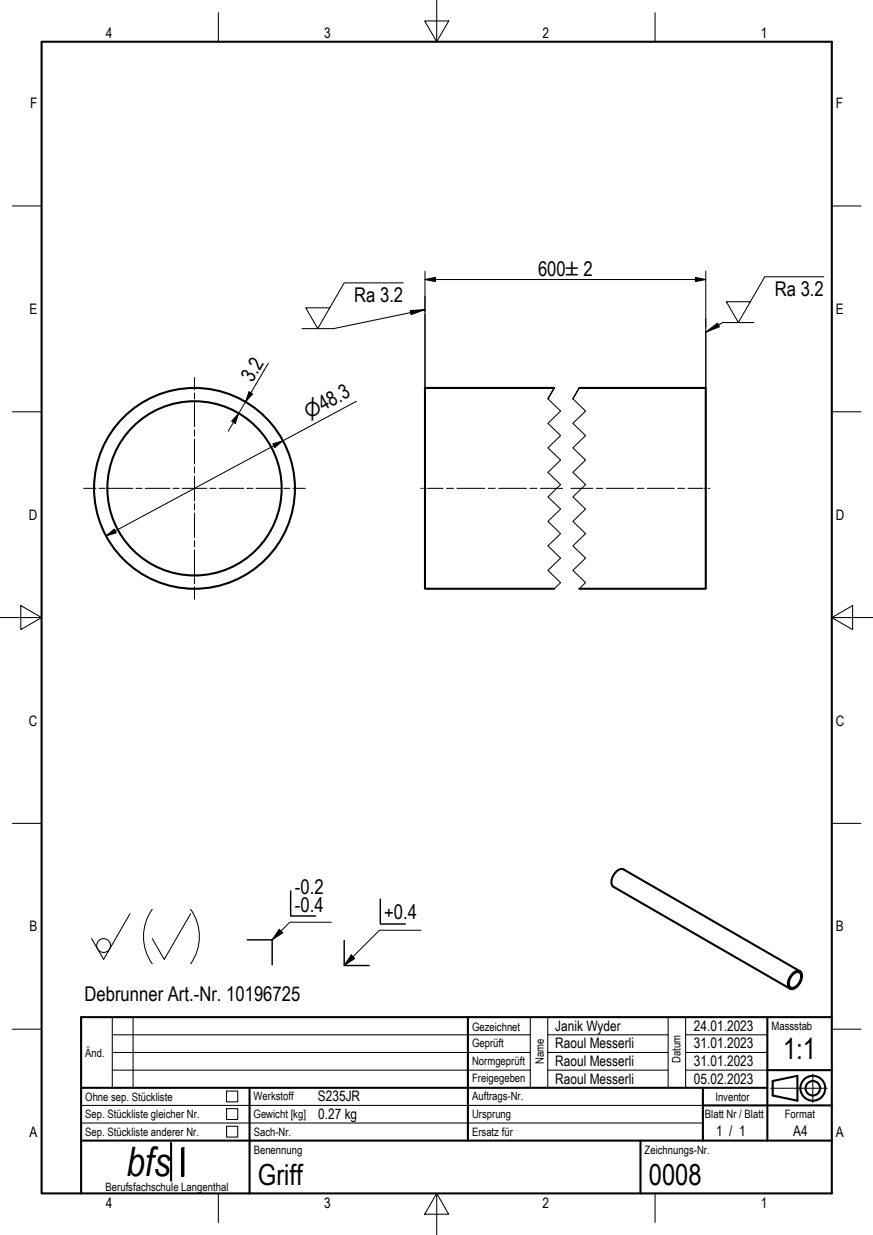
[picture p56: page 1]
Berufsfachschule Langenthal

Debrunner Art.-Nr. 10196725

Änd. | | Gezeichnet | | Janik Wyder | | 24.01.2023 | Massstab 1:1

Geprüft | | Raoul Messerli | | 31.01.2023
Normgeprüft | | Raoul Messerli | | 31.01.2023
Freigegeben | | Raoul Messerli | | 05.02.2023

Ohne sep. Stückliste | | Werkstoff S235JR | Auftrags-Nr. | Inventor
Sep. Stückliste gleicher Nr. | | Gewicht [kg] 0.27 kg | Ursprung | Blatt Nr / Blatt 1 / 1 | Format A4
Sep. Stückliste anderer Nr. | | Sach-Nr. | Ersatz für
