Janik313/Pflanzenwagen/40_Realisieren/10_Zeichungen/0009_Gummi Matte.pdf

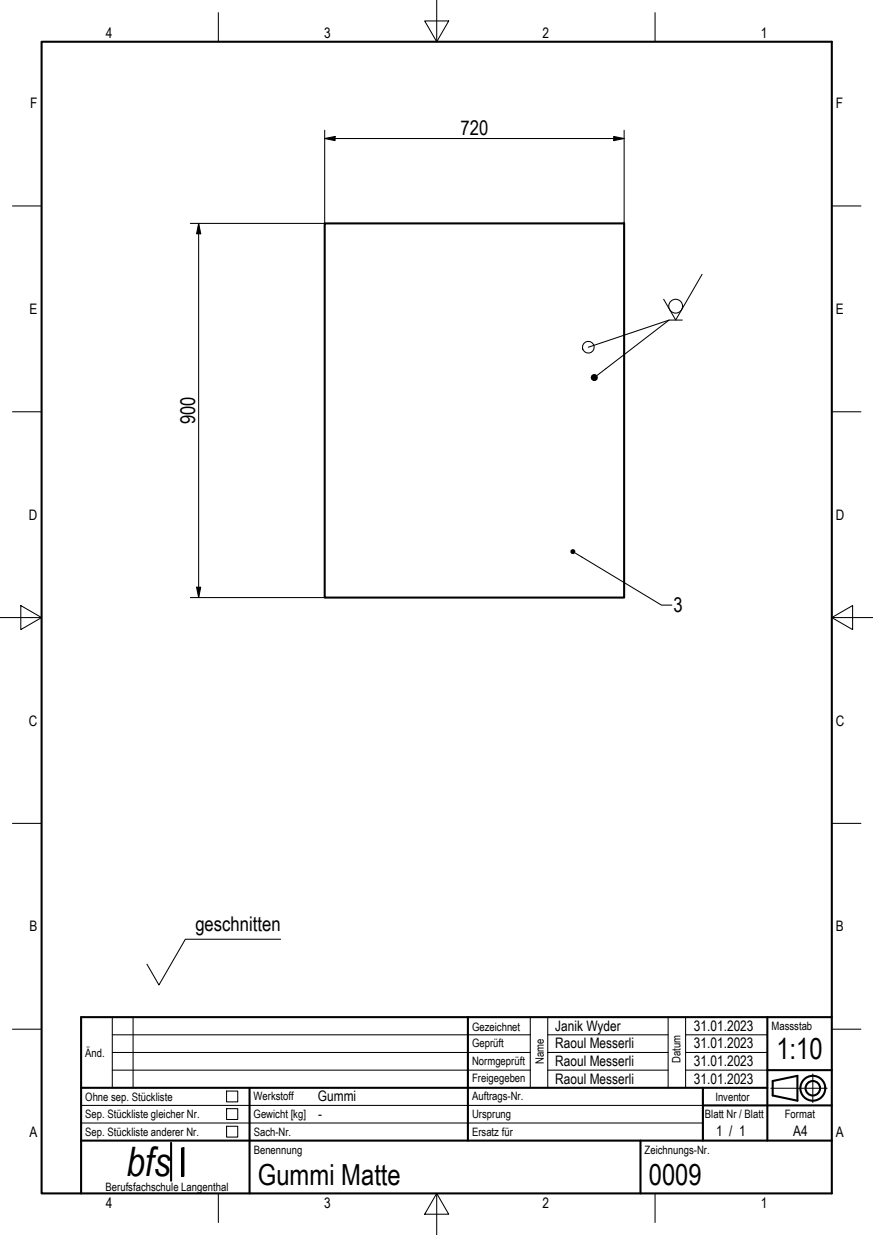
[picture p57: page 1]
Gummi Matte; Berufsfachschule Langenthal

Änd. | | Gezeichnet | | Janik Wyder | | 31.01.2023 | Massstab 1:10

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

Ohne sep. Stückliste | | Werkstoff Gummi | Auftrags-Nr. | Inventor
Sep. Stückliste gleicher Nr. | | Gewicht [kg] - | Ursprung | Blatt Nr / Blatt 1 / 1 | Format A4
Sep. Stückliste anderer Nr. | | Sach-Nr. | Ersatz für
