Janik313/Pflanzenwagen/40_Realisieren/10_Zeichungen/0101_Schweiss Baugruppe.pdf

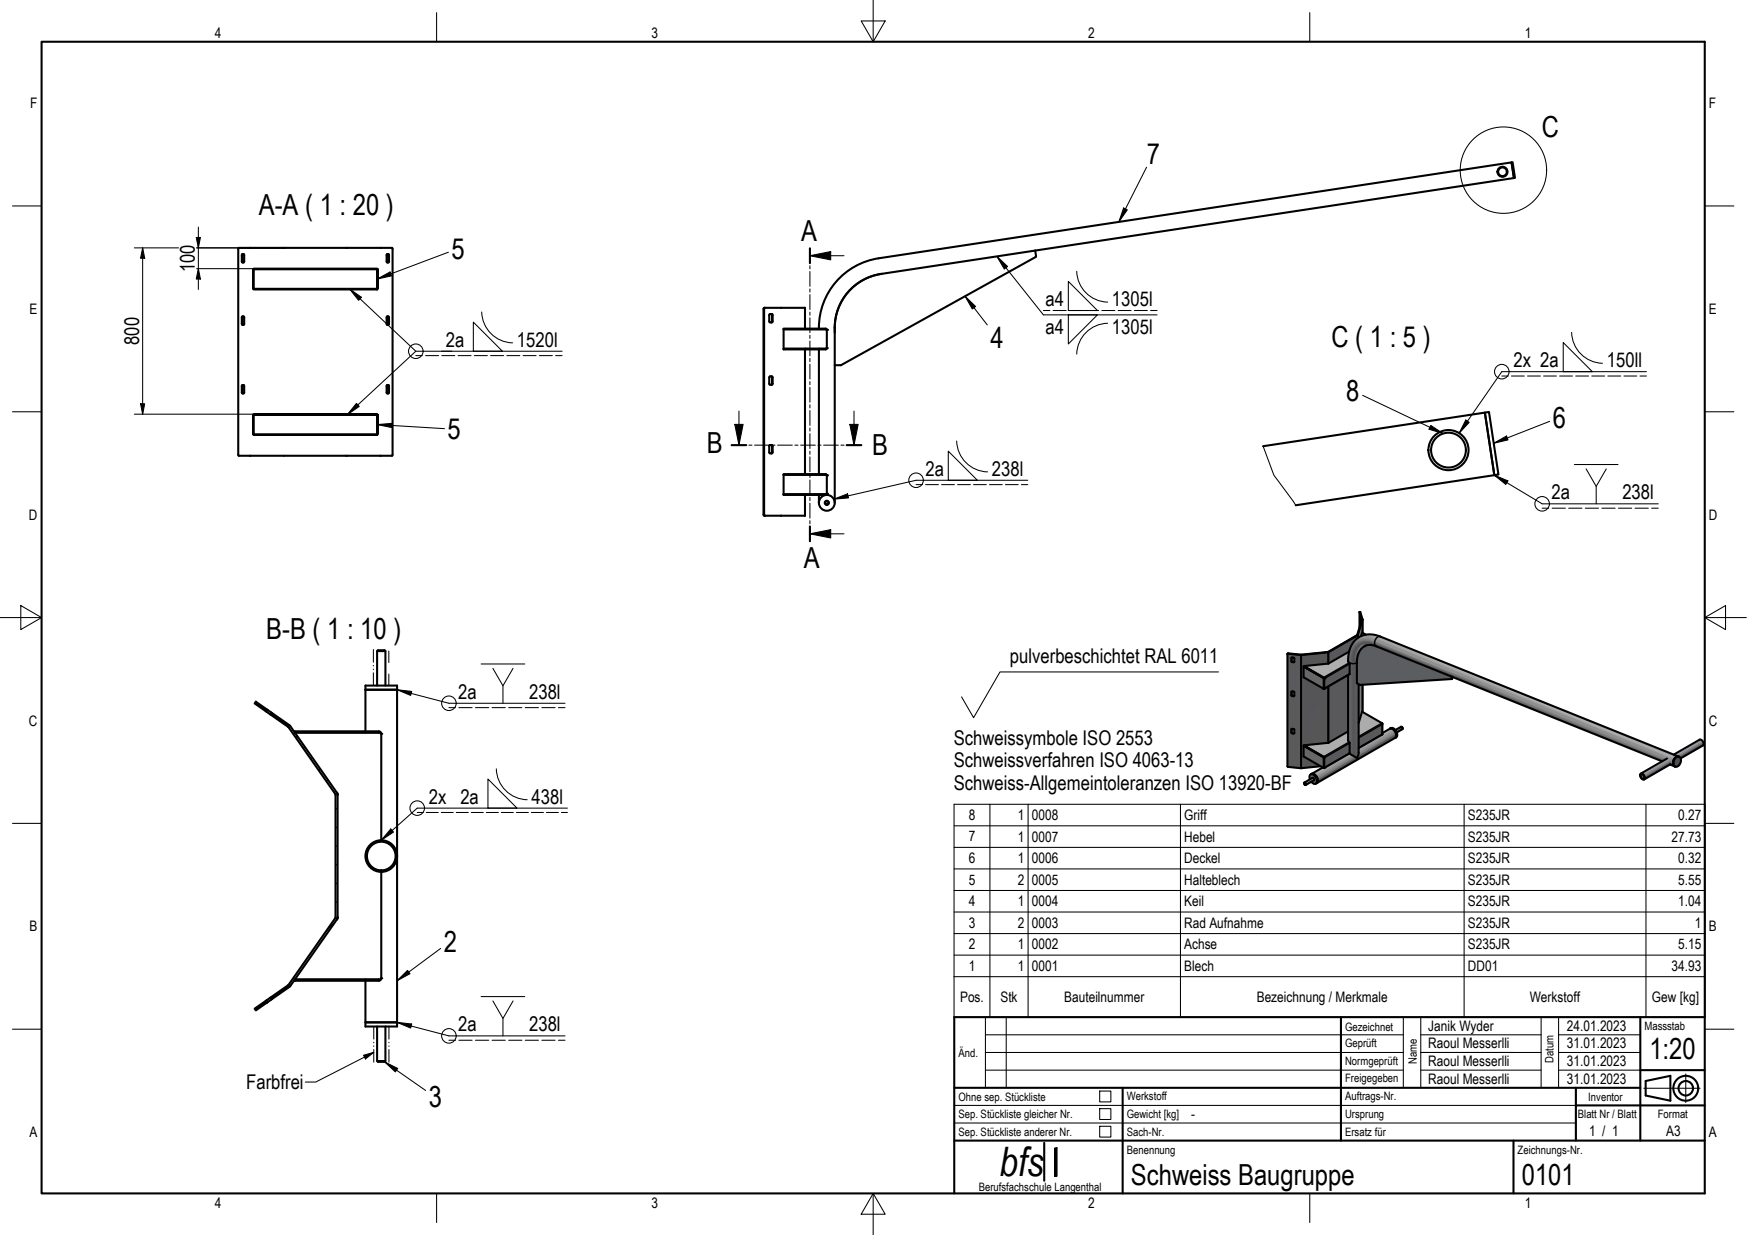
[picture p58: page 1]
150ll Schweissymbole ISO 2553 Schweissverfahren ISO 4063-13 Schweiss-Allgemeintoleranzen ISO 13920-BF pulverbeschichtet RAL 6011

8 | 1 | 0 0 0 8 | G riff | S 2 3 5 J R | 0.2 7
7 | 1 | 0 0 0 7 | H e b el | S 2 3 5 J R | 2 7.7 3
6 | 1 | 0 0 0 6 | D e c k el | S 2 3 5 J R | 0.3 2
5 | 2 | 0 0 0 5 | H alt e ble c h | S 2 3 5 J R | 5.5 5
4 | 1 | 0 0 0 4 | K eil | S 2 3 5 J R | 1.0 4
3 | 2 | 0 0 0 3 | R a d A u f n a h m e | S 2 3 5 J R | 1
2 | 1 | 0 0 0 2 | A c h s e | S 2 3 5 J R | 5.1 5
1 | 1 | 0 0 0 1 | Ble c h | D D 0 1 | 3 4.9 3

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

r. Normgeprüft Gezeichnet Geprüft | | rlli Raoul Messerlli Raoul Messerlli Janik Wyder | 3 1.0 1.2 0 2 3

r. Sep. Stückliste gleicher Nr. Änd. Ohne sep. Stückliste

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
