Janik313/Pflanzenwagen/00_Dokumentation/90_Vorlagen_Rondo/IPERKA-2.pdf

# Leitfaden Konstruktionsmethodik nach IPERKA

I

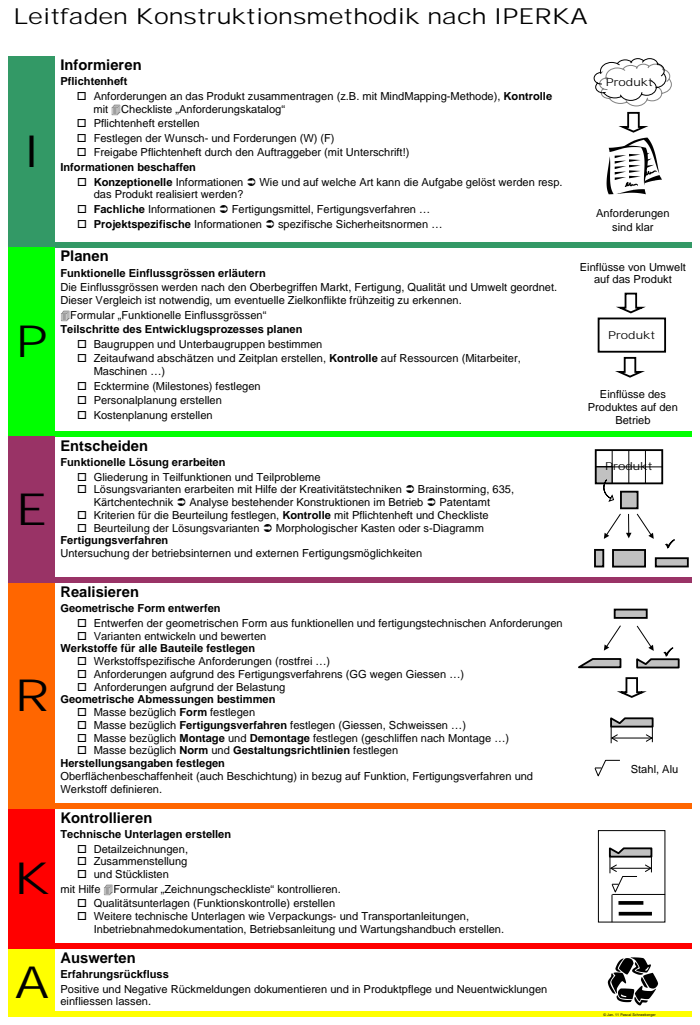
[picture p59: page 1]
Anforderungen sind klar; Untersuchung der betriebsinternen und externen Fertigungsmöglichkeiten; Stahl, Alu; Produkt

Informieren
Pflichtenheft
☐ Anforderungen an das Produkt zusammentragen (z.B. mit MindMapping-Methode), Kontrolle
mit Checkliste „Anforderungskatalog“
☐ Pflichtenheft erstellen
☐ Festlegen der Wunsch- und Forderungen (W) (F)
☐ Freigabe Pflichtenheft durch den Auftraggeber (mit Unterschrift!)
Informationen beschaffen
☐ Konzeptionelle Informationen Wie und auf welche Art kann die Aufgabe gelöst werden resp.
das Produkt realisiert werden?
☐ Fachliche Informationen Fertigungsmittel, Fertigungsverfahren …
☐ Projektspezifische Informationen spezifische Sicherheitsnormen …
Planen
Funktionelle Einflussgrössen erläutern
Die Einflussgrössen werden nach den Oberbegriffen Markt, Fertigung, Qualität und Umwelt geordnet.
Dieser Vergleich ist notwendig, um eventuelle Zielkonflikte frühzeitig zu erkennen.
Formular „Funktionelle Einflussgrössen“
Teilschritte des Entwicklugsprozesses planen
☐ Baugruppen und Unterbaugruppen bestimmen
☐ Zeitaufwand abschätzen und Zeitplan erstellen, Kontrolle auf Ressourcen (Mitarbeiter,
Maschinen …)
☐ Ecktermine (Milestones) festlegen
☐ Personalplanung erstellen
☐ Kostenplanung erstellen
Entscheiden
Funktionelle Lösung erarbeiten
☐ Gliederung in Teilfunktionen und Teilprobleme

Einflüsse von Umwelt
auf das Produkt

Einflüsse des
Produktes auf den
Betrieb

☐ Lösungsvarianten erarbeiten mit Hilfe der Kreativitätstechniken Brainstorming, 635,
Kärtchentechnik Analyse bestehender Konstruktionen im Betrieb Patentamt
☐ Kriterien für die Beurteilung festlegen, Kontrolle mit Pflichtenheft und Checkliste
☐ Beurteilung der Lösungsvarianten Morphologischer Kasten oder s-Diagramm
Fertigungsverfahren

Realisieren
Geometrische Form entwerfen
☐ Entwerfen der geometrischen Form aus funktionellen und fertigungstechnischen Anforderungen
☐ Varianten entwickeln und bewerten
Werkstoffe für alle Bauteile festlegen
☐ Werkstoffspezifische Anforderungen (rostfrei …)
Geometrische Abmessungen bestimmen
☐ Masse bezüglich Form festlegen
☐ Masse bezüglich Fertigungsverfahren festlegen (Giessen, Schweissen …)
☐ Masse bezüglich Montage und Demontage festlegen (geschliffen nach Montage …)
☐ Masse bezüglich Norm und Gestaltungsrichtlinien festlegen
Herstellungsangaben festlegen
Oberflächenbeschaffenheit (auch Beschichtung) in bezug auf Funktion, Fertigungsverfahren und
Werkstoff definieren.
Kontrollieren
Technische Unterlagen erstellen
☐ Detailzeichnungen,
Erfahrungsrückfluss
Positive und Negative Rückmeldungen dokumentieren und in Produktpflege und Neuentwicklungen
einfliessen lassen.

☐ Anforderungen aufgrund des Fertigungsverfahrens (GG wegen Giessen …)
☐ Anforderungen aufgrund der Belastung

☐ Zusammenstellung
☐ und Stücklisten
mit Hilfe Formular „Zeichnungscheckliste“ kontrollieren.
☐ Qualitätsunterlagen (Funktionskontrolle) erstellen
☐ Weitere technische Unterlagen wie Verpackungs- und Transportanleitungen,
Inbetriebnahmedokumentation, Betriebsanleitung und Wartungshandbuch erstellen.
Auswerten

© Jan. 11 Pascal Schneeberger
