Janik313/Pflanzenwagen/00_Dokumentation/90_Vorlagen_Rondo/Einkaufteile/BN_20210.pdf

HALDER EH 22110.

## BN 20210 - Rastbolzen kompakt mit metrischem Feingewinde und Sechskantbund mit

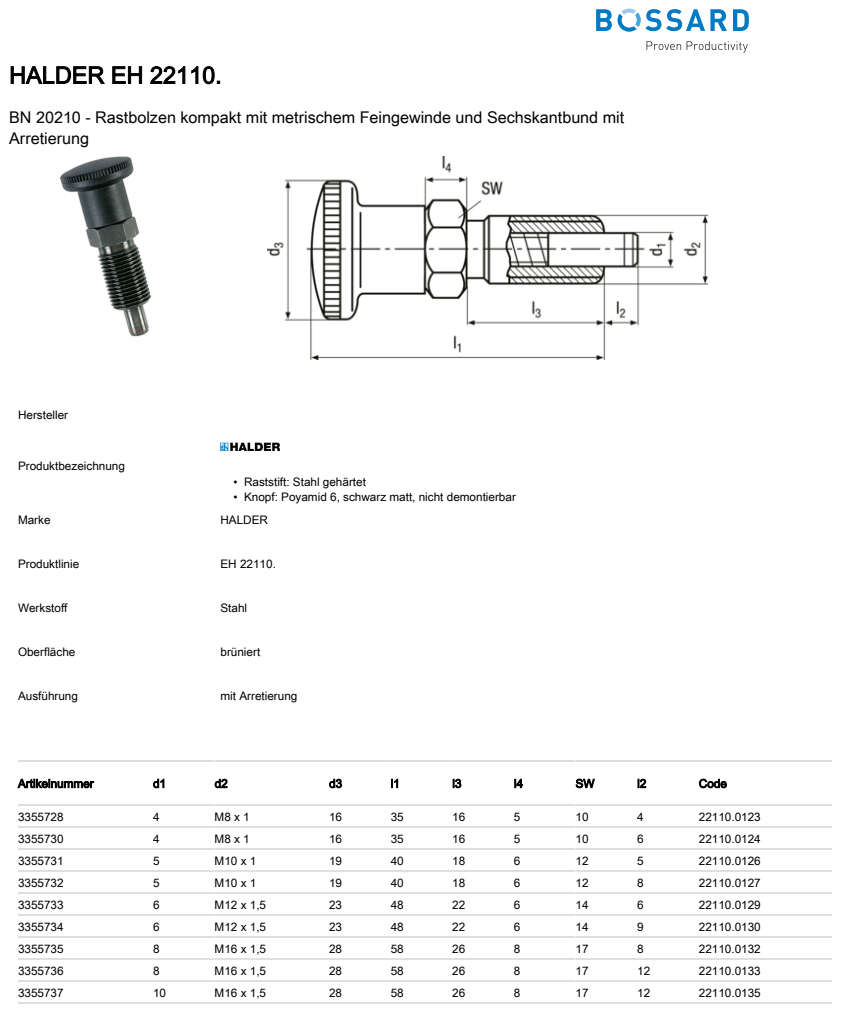
[picture p60: page 1]
Arretierung; Hersteller; Produktbezeichnung; Marke; HALDER; Produktlinie; Werkstoff; Stahl; Oberfläche; brüniert; Ausführung; mit Arretierung

• Raststift: Stahl gehärtet
• Knopf: Poyamid 6, schwarz matt, nicht demontierbar

Artikelnummer | d1 | d2 | d3 | l1 | l3 | l4 | SW | l2 | Code
