Janik313/Pflanzenwagen/00_Dokumentation/90_Vorlagen_Rondo/Einkaufteile/BN_21226.pdf

# ELESA® PMT.101-SST-A/AK

# BN 21226 - Rastbolzen mit Arretierung Raststift INOX

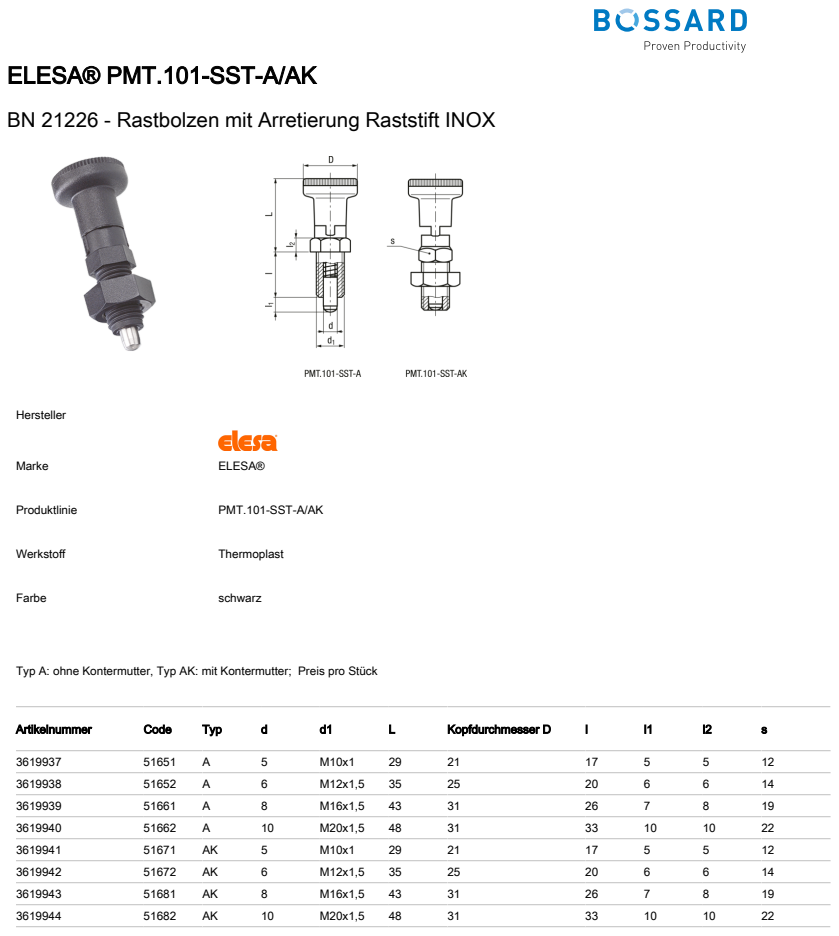
[picture p61: page 1]
Hersteller; Marke; ELESA®; Produktlinie; PMT.101-SST-A/AK; Werkstoff; Thermoplast; Farbe; schwarz

Typ A: ohne Kontermutter, Typ AK: mit Kontermutter; Preis pro Stück

Artikelnummer | Code | Typ | d | d1 | L | Kopfdurchmesser D | l | l1 | l2 | s
