Janik313/Pflanzenwagen/(commit log)

2023-01-03 Terimplan
    Terimplan erstelt
    [Terminplan.xls]
2023-01-03 Upload Rondovorlagen
    [Kostenplanung.xlsx, Morphologische Matrix.xlsx, S-Diagramm.xlsx, Vorlage Terminplan.xlsx]
2023-01-03 Pflichten Heft
    Pflichten Heft erstelt
    [Terminplan.xls]
2023-01-08 Planung
    Morphologischerkasten
    Terminplan Rondo
    [Morphologischerkasten.xlsx, Terminplan Rondo.xlsx, Terminplan.xls, Vorlage Terminplan.xlsx]
2023-01-09 Planen & Entscheiden grösstenteils abgeschlossen
    - Alle bisherigen Arbeitsschritte in der Dokumentation nachgetragen
    - Mindmap erstellt
    - Morphologische Matrix erstellt
    - Pflichtenheft überarbeitet
    - S-Diagramm erstellt
    - Terminplan neu gestalltet
    [Morphologische_Matrix.xlsx, Morphologischerkasten.xlsx, S-Diagramm.xlsx, Terminplan Rondo.xlsx, Terminplan.xls, Terminplan.xlsx, Vorlage Terminplan.xlsx]
2023-01-09 Lösungsvariante geändert
    Lösungsvariante 1 war Lösungsvariante 2
    [S-Diagramm.xlsx]
2023-01-10 Farbänderung in S-Diagramm
    Grün wurde grüner gemacht
    [S-Diagramm.xlsx]
2023-01-31 Inventor Palme erstellt
    [Blech.0002.ipt, Norm.0001.dwg, Norm.0001.ipn, Norm.0002.iam, Norm.0003.ipt, Norm.0009.idw, Palme.iam, Schweisskonstruktion.0002.iam]
2023-02-01 Inventor: Topf Wagen Schnittstelle
    [Achse.ipt, Blech1.0002.ipt, Blech1.ipt, C_clip.ipt, Cross.ipt, DynamicSpring.ipt, Gear.ipt, Hook.ipt]
2023-02-02 Dokumentation: Nachtragen
    - Dokumentation bis Realisieren ausgefüllt
    - S-Diagramm um neue Lösungsvariante ergänzt
    - Terminplan nachgetragen
    [Bewertungsbogen Pflanzenwagen.xlsx, S-Diagramm.xlsx, Terminplan.xlsx]
2023-02-02 Inventor Hebel
    [Achse.0001.ipt, Achse.ipt, BN 161 1118811 prevailing torque type hex lock nut M20_Steel 6.ipt, Halteblech.0001.ipt, Halteblech.ipt, Hebel.ipt, Rad Aufnahme.0002.ipt, Rad Aufnahme.ipt]
2023-02-02 Inventor Step Finish
    [Deckel.ipt, Griff.0001.ipt, Griff.ipt, Halteblech.0001.ipt, Halteblech.0002.ipt, Halteblech.ipt, Hebel.0003.ipt, Hebel.ipt]
2023-02-03 Dokumentation: Realisieren fast abgeschlossen
    - Konzept- und Prinzipskizze nachgetragen
    - Berechnungen gemacht
    - Dokumentation nachgetragen
    [Bewertungsbogen Pflanzenwagen.xlsx]
2023-02-03 Ordnerstruktur aktualisiert
    - Ordnerstruktur nach IPERKA angepasst
    - Skizze Variante 4
    - Skizze Variante 4 in Dokumentation nachgetragen
    [Achse.0001.ipt, Achse.ipt, BN 161 1118811 prevailing torque type hex lock nut M20_Steel 6.ipt, Bewertungsbogen Pflanzenwagen.xlsx, Blech.0002.ipt, Blech1.0002.ipt, Blech1.ipt, C_clip.ipt]
2023-02-05 Inventor Zeichungen
    [Achse.0001.ipt, Achse.0002.ipt, Achse.0006.idw, Achse.idw, Achse.ipt, Blech1.0002.ipt, Blech1.0005.ipt, Blech1.0009.idw]
2023-02-06 Inventor Baugruppe Finish
    [BN 161 1118811 prevailing torque type hex lock nut M20_Steel 6.0001.ipt, BN 161 1118811 prevailing torque type hex lock nut M20_Steel 6.ipt, Baugruppe.0003.iam, Baugruppe.0003.idw, Baugruppe.iam, Baugruppe.idw, Blech1.0009.idw, Blech1.0010.idw]
2023-02-06 Dokumentation: Kontrolle + Auswertung
    - In der Dokumentation Kontrolle und Auswertung fertig geschrieben
    - Im Pflichtenheft nachgetragen ob die Vorgaben erfüllt sind
    - Kostenkalkulation gemacht
    - Terminplan Personen nachgetragen
    - Bewertungsbogen weiter abgehakt
    [Bewertungsbogen Pflanzenwagen.xlsx, Kostenkalkulation.xlsx, Terminplan.xlsx]
2023-02-06 Doku über arbeitig
    [Blech1.0010.idw, Blech1.0011.idw, Blech1.idw, Halteblech.0001.idw, Halteblech.0002.idw, Halteblech.idw, Keil.0001.idw, Keil.0003.idw]
2023-02-06 Berechung für Spann gurte
    [Baugruppe.0003.iam, Baugruppe.0004.iam, Baugruppe.iam, Schweiss Baugruppe.0005.iam, Schweiss Baugruppe.0006.iam, Schweiss Baugruppe.iam]
2023-02-06 Inventor Materialien geprüft
    [Baugruppe.0004.iam, Baugruppe.0005.iam, Baugruppe.iam, Rad Aufnahme.0007.idw, Rad Aufnahme.0008.idw, Rad Aufnahme.idw, Schweiss Baugruppe.0006.iam, Schweiss Baugruppe.0007.iam]
2023-02-06 Inventor Datum anpassung
    [Achse.0006.idw, Achse.0007.idw, Achse.idw, Baugruppe.0003.idw, Baugruppe.0004.idw, Baugruppe.0005.iam, Baugruppe.0006.iam, Baugruppe.iam]
2023-02-06 Dokumentation: Fertig
    - Dokumentation abgeschlossen
    - Rechtschreibung im Arbeitsjournal korrigiert
    [Bewertungsbogen Pflanzenwagen.xlsx]
2023-02-07 Verkauf Presi
    [Baugruppe.0004.idw, Baugruppe.0005.idw, Baugruppe.idw, Baugruppe.newVer.iam, Blech1.0013.idw, Blech1.0014.idw, Blech1.idw, Schweiss Baugruppe.0001.idw]
